bjornburton/ChampBot2016/Firmware/jawAndFireControl/jafco.tex

\input cwebmac

% jafco
\input miniltx
\input graphicx

\nocon % omit table of contents
\datethis % print date on listing

\N{1}{1}Introduction. This is the firmware portion of Jaw and Fire control.

This will facilitate two actions: opening the jaw to release the floating
object and light the target on fire.

The jaw will close by return-spring so the action will to open it.

Fire is a  sequence of opening the jaw, releasing the butane and firing the
ignitor.

\vskip 4 pc
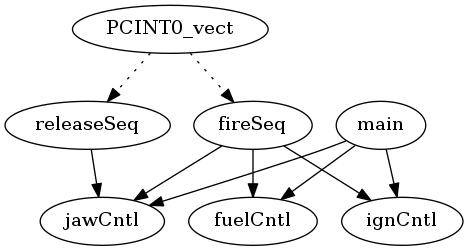
[picture p1: Firmware/jawAndFireControl/jafco.png]


Extensive use was made of the datasheet, Atmel ``Atmel ATtiny25, ATtiny45,
ATtiny85 Datasheet'' Rev. 2586Q–AVR–08/2013 (Tue 06 Aug 2013 03:19:12 PM
EDT)
and ``AVR130: Setup and Use the AVR Timers'' Rev. 2505A–AVR–02/02.
\Y\B\X4:Include\X\6
\X5:Prototypes\X\6
\X6:Global variables\X\par
\fi

\M{2}\PB{\.{"F\_CPU"}} is used to convey the Trinket clock rate.
\Y\B\4\D$\.{F\_CPU}$ \5
\T{8000000\$U\$L}\par
\fi

\M{3}Here are some Boolean definitions that are used.
\Y\B\4\D$\.{ON}$ \5
\T{1}\par
\B\4\D$\.{OFF}$ \5
\T{0}\par
\B\4\D$\.{OPEN}$ \5
\T{1}\par
\B\4\D$\.{CLOSE}$ \5
\T{0}\par
\B\4\D$\.{SET}$ \5
\T{1}\par
\B\4\D$\.{CLEAR}$ \5
\T{0}\par
\fi

\M{4}\B\X4:Include\X${}\E{}$\6
\8\#\&{include} \.{<avr/io.h>}\SHC{ need some port access }\6
\8\#\&{include} \.{<util/delay.h>}\SHC{ need to delay }\6
\8\#\&{include} \.{<avr/interrupt.h>}\SHC{ have need of an interrupt }\6
\8\#\&{include} \.{<avr/sleep.h>}\SHC{ have need of sleep }\6
\8\#\&{include} \.{<avr/wdt.h>}\SHC{ have need of watchdog }\6
\8\#\&{include} \.{<stdlib.h>}\6
\8\#\&{include} \.{<stdint.h>}\par
\U1.\fi

\M{5}\B\X5:Prototypes\X${}\E{}$\6
\&{void} \\{jawCntl}(\\{uint8\_t}\\{state});\SHC{ Jaw open and close }\6
\&{void} \\{fuelCntl}(\\{uint8\_t}\\{state});\SHC{ Fuel on and off }\6
\&{void} \\{ignCntl}(\\{uint8\_t}\\{state});\SHC{ on and off }\6
\&{void} \\{releaseSeq}(\&{void});\6
\&{void} \\{fireSeq}(\&{void});\par
\U1.\fi

\M{6}
My lone global variable is a function pointer.
This lets me pass arguments to the actual interrupt handlers, should I need to.
This pointer gets the appropriate function attached by one of the \PB{%
\.{"ISR()"}}
functions.

\Y\B\4\X6:Global variables\X${}\E{}$\6
\&{void} ${}({*}\\{handleIrq})(\,)\K\NULL{}$;\6
\&{int} \\{main}(\&{void})\1\1\6
$\{{}$\6
\X28:Initialize interrupts\X\6
\X27:Initialize pin inputs\X\6
\X24:Initialize pin outputs\X\6
\X26:Initialize Timer\X\par
\U1.\fi

\M{7}
Of course, any interrupt function requires that bit ``Global Interrupt Enable''
is set; usually done through calling sei(). Doing this after the pin setup is
the best time.
\Y\B\\{sei}(\,);\par
\fi

\M{8}
Rather than burning loops, waiting for something to happen,
the ``sleep'' mode is used.
The specific type of sleep is `idle'.
In idle, execution stops but timers continue.
Interrupts are used to wake it.
\Y\B\X34:Configure to wake upon interrupt\X\par
\fi

\M{9}
This is the loop that does the work.
It should spend most of its time in \PB{\\{sleep\_mode}},
comming out at each interrupt event.

\Y\B\&{for} ( ;  ; \,)\6
$\{{}$\par
\fi

\M{10}
We don't want anything cooking while we are asleap.
\Y\B\\{ignCntl}(\.{OFF});\6
\\{fuelCntl}(\.{OFF});\6
\\{jawCntl}(\.{CLOSE});\par
\fi

\M{11}
Now we wait in ``idle'' for any interrupt event.
\Y\B\\{sleep\_mode}(\,);\par
\fi

\M{12}
If execution arrives here, some interrupt has been detected.
\Y\B\&{if} ${}(\\{handleIrq}\I\NULL{}$)\SHC{ not sure why it would be, but to
be safe }\6
${}\{{}$\1\6
\\{handleIrq}(\,);\6
${}\\{handleIrq}\K\NULL{}$;\SHC{ reset so that the action cannot be repeated }\6
\4${}\}{}$\SHC{ end if handleIrq }\2\6
$\}{}$\SHC{ end for }\6
\&{return} \T{0};\SHC{ it's the right thing to do! }\6
$\}{}$\SHC{ end main() }\par
\fi

\N{1}{13}Interrupt Handling.

\Y\B\&{void} \\{releaseSeq}(\,)\1\1\6
$\{{}$\par
\fi

\M{14}
This sequence will proceed only while the button is held.
\Y\B\\{jawCntl}(\.{OPEN});\6
\&{while} ${}(\R(\.{PINB}\AND(\T{1}\LL\.{PB3}))){}$\1\5
\\{\_delay\_ms}(\T{10});\2\6
\\{jawCntl}(\.{CLOSE}); $\}{}$\par
\fi

\M{15}

\Y\B\&{void} \\{fireSeq}(\,)\1\1\6
$\{{}$\6
\\{uint8\_t}\\{firingState};\7
\&{enum} \&{firingStates} ${}\{{}$\1\6
${}\\{ready},\39\\{opened},\39\\{igniting},\39\\{burning},\39\\{cooling}{}$\2\6
${}\};{}$\7
${}\\{firingState}\K\\{ready}{}$;\par
\fi

\M{16}
This sequence will proceed only while the button is held.
It can terminate after any state.
\PB{\.{"\_delay\_ms()"}} is a handy macro good for $2^{16}$ milliseconds of
delay.
\Y\B\&{while} ${}(\R(\.{PINB}\AND(\T{1}\LL\.{PB4})))$ $\{{}$\par
\fi

\M{17}
The jaw opens here for fire.
\Y\B\&{if} ${}(\\{firingState}\E\\{ready}){}$\5
${}\{{}$\1\6
\\{jawCntl}(\.{OPEN});\6
${}\\{firingState}\K\\{opened};{}$\6
\&{continue};\6
\4${}\}{}$\2\par
\fi

\M{18}
CDI is switched on.
\Y\B\&{if} ${}(\\{firingState}\E\\{opened}){}$\5
${}\{{}$\1\6
\\{ignCntl}(\.{ON});\6
${}\\{firingState}\K\\{igniting};{}$\6
\&{continue};\6
\4${}\}{}$\2\par
\fi

\M{19}
Fuel opens.
\Y\B\&{if} ${}(\\{firingState}\E\\{igniting}){}$\5
${}\{{}$\1\6
\\{fuelCntl}(\.{ON});\6
${}\\{firingState}\K\\{burning};{}$\6
\&{continue};\6
\4${}\}{}$\2\6
\\{\_delay\_ms}(\T{10}); $\}{}$\par
\fi

\M{20}
Once the loop fails we set fuel and ignitor off and close the jaw.
\Y\B\\{ignCntl}(\.{OFF});\6
\\{fuelCntl}(\.{OFF});\6
\\{jawCntl}(\.{CLOSE}); $\}{}$\par
\fi

\N{1}{21}The ISRs.

The ISRs are pretty skimpy as they mostly used to point \PB{\\{handleIrq}(\,)}
to
the correct function.
The need for global variables is minimized.

\fi

\M{22}
This vector responds to the jaw input at pin PB3 or fire input at PB4.
A simple debounce is included.
\Y\B\.{ISR}(\\{PCINT0\_vect})\6
${}\{{}$\1\6
\&{const} \\{int8\_t}\\{high}${}\K\T{32};{}$\6
\&{const} \\{int8\_t}\\{low}${}\K{-}\\{high};{}$\7
${}\\{int8\_t}\\{dbp3}\K\T{0};{}$\6
${}\\{int8\_t}\\{dbp4}\K\T{0};{}$\6
\&{while} ${}(\\{abs}(\\{dbp3})<\\{high}){}$\5
${}\{{}$\1\6
\&{if} ${}(\R(\.{PINB}\AND(\T{1}\LL\.{PB3}))\W\\{dbp3}>\\{low}){}$\1\5
${}\\{dbp3}\MM;{}$\2\6
\&{else} \&{if} ${}((\.{PINB}\AND(\T{1}\LL\.{PB3}))\W\\{dbp3}<\\{high}){}$\1\5
${}\\{dbp3}\PP;{}$\2\6
\\{\_delay\_ms}(\T{1});\6
\4${}\}{}$\2\6
\&{while} ${}(\\{abs}(\\{dbp4})<\\{high}){}$\5
${}\{{}$\1\6
\&{if} ${}(\R(\.{PINB}\AND(\T{1}\LL\.{PB4}))\W\\{dbp4}>\\{low}){}$\1\5
${}\\{dbp4}\MM;{}$\2\6
\&{else} \&{if} ${}((\.{PINB}\AND(\T{1}\LL\.{PB4}))\W\\{dbp4}<\\{high}){}$\1\5
${}\\{dbp4}\PP;{}$\2\6
\\{\_delay\_ms}(\T{1});\6
\4${}\}{}$\2\6
\&{if} ${}(\\{dbp3}\E\\{low}){}$\1\5
${}\\{handleIrq}\K{\AND}\\{releaseSeq};{}$\2\6
\&{else} \&{if} ${}(\\{dbp4}\E\\{low}){}$\1\5
${}\\{handleIrq}\K{\AND}\\{fireSeq};{}$\2\6
\4${}\}{}$\2\par
\fi

\N{1}{23}These are the supporting routines, procedures and configuration
blocks.

Here is the block that sets-up the digital I/O pins.
\fi

\M{24}\B\X24:Initialize pin outputs\X${}\E{}$\6
${}\{{}$\SHC{ 14.4.9 DDRD – The Port D Data Direction Register }\C{ set the
jaw port direction }\1\6
${}\.{DDRB}\MRL{{\OR}{\K}}(\T{1}\LL\.{DDB0}){}$;\C{ set the fuel port direction
}\6
${}\.{DDRB}\MRL{{\OR}{\K}}(\T{1}\LL\.{DDB1}){}$;\C{ set the ignition port
direction }\6
${}\.{DDRB}\MRL{{\OR}{\K}}(\T{1}\LL\.{DDB2});{}$\6
\4${}\}{}$\2\par
\U6.\fi

\M{25}
Timer Counter 0 is configured for ``Phase Correct'' PWM which, according to the
datasheet, is preferred for motor control.
OC0A and OC0B are set to clear on a match which creates a
non-inverting PWM.
\Y\B\par
\fi

\M{26}\B\X26:Initialize Timer\X${}\E{}$\6
${}\{{}$\SHC{ 15.9.1 TCCR0A – Timer/Counter Control Register A }\1\6
${}\.{TCCR0A}\MRL{{\OR}{\K}}(\T{1}\LL\.{WGM00}){}$;\SHC{ Phase correct, mode 1
of PWM (table 15-9) }\6
${}\.{TCCR0A}\MRL{{\OR}{\K}}(\T{1}\LL\.{COM0A1}){}$;\SHC{ Set/Clear on
Comparator A match (table 15-4) }\6
${}\.{TCCR0A}\MRL{\AND{\K}}\CM(\T{1}\LL\.{COM0A0}){}$;\SHC{ Set  on Comparator
A match (table 15-4) }\6
${}\.{TCCR0A}\MRL{{\OR}{\K}}(\T{1}\LL\.{COM0B1}){}$;\SHC{ Set/Clear on
Comparator B match (table 15-7) }\6
${}\.{TCCR0A}\MRL{\AND{\K}}\CM(\T{1}\LL\.{COM0B0}){}$;\SHC{ Set on Comparator B
match (table 15-7) }\SHC{ 15.9.2 TCCR0B – Timer/Counter Control Register B }\6
${}\.{TCCR0B}\MRL{{\OR}{\K}}(\T{1}\LL\.{CS01}){}$;\SHC{ Prescaler set to clk/8
(table 15-9) }\6
\4${}\}{}$\2\par
\U6.\fi

\M{27}\B\X27:Initialize pin inputs\X${}\E{}$\6
${}\{{}$\C{ set the jaw input pull-up }\1\6
${}\.{PORTB}\MRL{{\OR}{\K}}(\T{1}\LL\.{PORTB3}){}$;\C{ set the fire input
pull-up }\6
${}\.{PORTB}\MRL{{\OR}{\K}}(\T{1}\LL\.{PORTB4});{}$\6
\4${}\}{}$\2\par
\U6.\fi

\M{28}\B\X28:Initialize interrupts\X${}\E{}$\6
${}\{{}$\C{ enable  change interrupt for jaw input }\1\6
${}\.{PCMSK}\MRL{{\OR}{\K}}(\T{1}\LL\.{PCINT3}){}$;\C{ enable  change interrupt
for fire input }\6
${}\.{PCMSK}\MRL{{\OR}{\K}}(\T{1}\LL\.{PCINT4}){}$;\C{ General interrupt Mask
register }\6
${}\.{GIMSK}\MRL{{\OR}{\K}}(\T{1}\LL\.{PCIE});{}$\6
\4${}\}{}$\2\par
\U6.\fi

\M{29}
Here is a simple procedure to operate the jaw.
\Y\B\&{void} \\{jawCntl}(\\{uint8\_t}\\{state})\6
${}\{{}$\1\6
\&{if} (\\{state})\5
${}\{{}$\1\6
${}\.{OCR0A}\K\T{\^ff\$U};{}$\6
\\{\_delay\_ms}(\T{250});\6
${}\.{OCR0A}\K\T{\^cc\$U};{}$\6
\4${}\}{}$\2\6
\&{else}\5
${}\{{}$\1\6
${}\.{OCR0A}\K\T{\^00\$U};{}$\6
\4${}\}{}$\2\6
\4${}\}{}$\2\par
\fi

\M{30}
Here is a simple procedure to operate the fuel.
\Y\B\&{void} \\{fuelCntl}(\\{uint8\_t}\\{state})\6
${}\{{}$\1\6
\&{if} (\\{state})\5
${}\{{}$\1\6
${}\.{OCR0B}\K\T{\^ff\$U};{}$\6
\\{\_delay\_ms}(\T{250});\6
${}\.{OCR0B}\K\T{\^ff\$U};{}$\6
\4${}\}{}$\2\6
\&{else}\5
${}\{{}$\1\6
${}\.{OCR0B}\K\T{\^00\$U};{}$\6
\4${}\}{}$\2\6
\4${}\}{}$\2\par
\fi

\M{31}
Here is a simple procedure to operate the ignition.
\Y\B\&{void} \\{ignCntl}(\\{uint8\_t}\\{state})\6
${}\{{}$\1\6
${}\.{PORTB}\K\\{state}\?\.{PORTB}\OR(\T{1}\LL\.{PORTB2}):\.{PORTB}\AND\CM(%
\T{1}\LL\.{PORTB2});{}$\6
\4${}\}{}$\2\par
\fi

\M{32}
See section the datasheet for details on the Watchdog Timer.
We are not using it right now.
\fi

\M{33}\B\X33:Initialize watchdog timer\X${}\E{}$\6
${}\{{}$\1\6
${}\.{WDTCR}\MRL{{\OR}{\K}}(\T{1}\LL\.{WDCE})\OR(\T{1}\LL\.{WDE});{}$\6
${}\.{WDTCR}\K(\T{1}\LL\.{WDIE})\OR(\T{1}\LL\.{WDP2}){}$;\SHC{ reset after
about 0.25 seconds }\6
\4${}\}{}$\2\par
\fi

\M{34}
Setting these bits configure sleep\_mode() to go to ``idle''.
Idle allows the counters and comparator to continue during sleep.

\Y\B\4\X34:Configure to wake upon interrupt\X${}\E{}$\6
${}\{{}$\1\6
${}\.{MCUCR}\MRL{\AND{\K}}\CM(\T{1}\LL\.{SM1});{}$\6
${}\.{MCUCR}\MRL{\AND{\K}}\CM(\T{1}\LL\.{SM0});{}$\6
\4${}\}{}$\2\par

\U8.\fi

\inx
\fin
\con
