bjornburton/ChampBot2016/Firmware/propulsion/piruett.pdf

§1 | PIRUETT | INTRODUCTION | 1

September 22, 2016 at 15:41

1. | Introduction. | This is the firmware portion of the propulsion and dive system for our 2016 Champbot.
It features separate thrust and steering, including piruett turning.
It facilitates lateral motion by taking “thrust” and “radius” pulse-width, or PWC, inputs from the RC receiver and converting them to the appropriate motor actions.
Thrust is receiver-channel 2, entering analog input ADC1 (PC1), and Radius is channel 1, at ADC0 (PC0). The action will be similar to driving an RC car or boat. By keeping it natural, it should be easier to navigate the course than with a skid-steer style control.
For PWM we are using Timer Counter 0. We are using the Wingxing DBH−01 (B/C) and the Inputs are unique on this. The PWM logic input goes to two different pins, depending on direction! The non-PWM pin must be held low. This is a big problem since PWM outputs have dedicated pins. Two AVR timers would be needed to control two motors; wasteful.
The odd example in the DBH−01 datasheet has PWM on IN1 and LOW on IN2 for forward. For reverse, LOW on IN1 and PWM on IN2.
Ruling out multiple timers (four comparators), additional outputs, or a PLD, the best solution we could find was a adding glue logic. A single 74F02 was chosen; a quad NOR. Keeping this solution simple, i.e. one

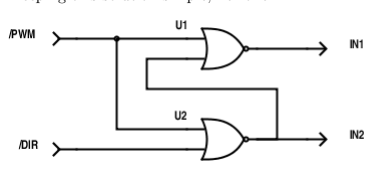
[picture p2: figure]

gate-type and on one chip, required that the AVR outputs be inverted. | a
This one chip handles the logic for both motors. With this, the AVR outputs direction on one pin and PWM
on the other. At the H-Bridge, the pin receiving PWM is selected based on motor direction. The remaining,
non-PWM pin, is held low.
PWM is OC0B and OC0A (PD5 and PD6), located on Trinket pins 5 an 6. The A fail-safe relay output will be at pin 8 (PB0).
For 2016 an autonomous dive function has been added. As in 2015, dive is performed by full reverse thrust but, with this new feature, this thrust is modulated to maintain a specified depth, as determined by a pressure sensor in the electronics bay. The sensor signal connects to ADC2 (PC2) through a voltage divider. The divider scales the 5 volt range of the sensor to the 1.1 volt range of the ADC. By program, it will maintain this depth for 12 seconds, two seconds longer than required.
This timing is through a tick interrupt by Timer Counter 2.
Dive is initiated by a low signal on FTDI pin #4. A relay circuit across FTDI #4 and #1 (Gnd) will do this.

2 | IMPLEMENTATION | PIRUETT | §2
2. | Implementation. | The Flysky FS-IA6 receiver has six PWC channels. The pulse-width from the
receiver is at 20 ms intervals but is adjustable. The pulses start simultaneously but end at the time corresponding to the controls. The on-time probably ranges from 1000–2000 µs including trim. 1500 µs is the pulse-width for center or stop. The levers may cover ±400 µs and the trim may cover the last 100 µs. The median time will be subtracted from them for a pair of signed values thrust and radius. The value will be scaled.
The thrust and radius will be translated to power to the port and starboard motors. When near median the motors will be disabled through a dead-band. Stiction in the motor probably wouldn’t allow it to move anyway, at this low duty-cycle. Both the PWM and safety relay will open. The motors will also be disabled when there are no input pulses; in this way champ wont run-off if the range is exceeded. This function is handled by the watchdog timer.
The radius control will also be the rotate control, if thrust is zero. Timer-Counter 0 is used for the PWM. The ATmega328 has a 16 bit PWMs with two comparators, Timer 1. This has an “Input Capture Unit” that may be used for PWC decoding. PWC being the type of signal from the RC receiver. That seems like as elegant a solution as I will find and it is recommended by Atmel to use it for this purpose.
The best way to use this nice feature is to take the PWC signals into the MUX, through the comparator and into the Input Capture Unit.
For the PWC measurement, this app note, AVR135, is helpful: www.atmel.com/images/doc8014.pdf In the datasheet, section 16.6.3 is helpful.
After each pulses captured from its respective channel, there’s an 18 ms dead-time. That’s over 250,000 clock cycles. This will provide ample time to sample pressure and do all of the math and set the motor PWMs.
Extensive use was made of the datasheet, Atmel “Atmel-8271I-AVR- ATmega-Datasheet 10/2014”.

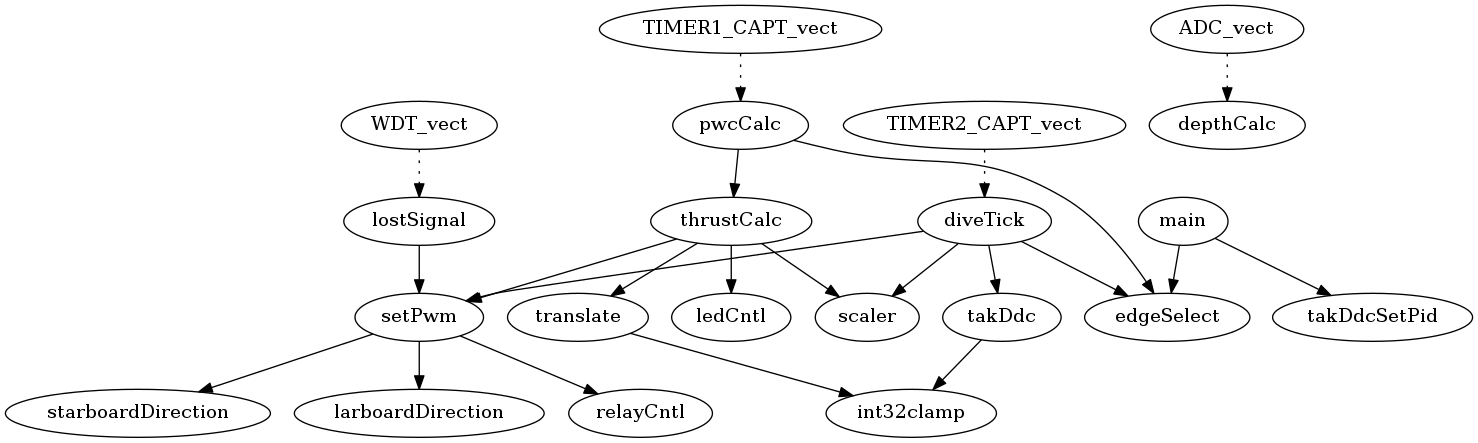
[picture p3: figure]

This is essentially a boat and so I originally wanted to use the word “Port” for the left-hand side, when facing the front. On a micro-controller that name is used for all of the ports so I chose the older word “larboard”.
hInclude 7 i
h Types 8 i
hPrototypes 14 i
h Global variables 15 i
3. F_CPU is used to convey the Trinket Pro clock rate. #define F_CPU 16000000UL

§4 | PIRUETT | BOOLEAN DEFINITIONS USED EVERYWHERE | 3
4. Boolean definitions used everywhere.
#define ON 1

#define OFF 0

#define SET 1

#define CLEAR 0

#define TRUE 1

#define FALSE 0

#define FORWARD 1

#define REVERSE 0

#define CLOSED 1

#define OPEN 0

#define AUTOMATIC 1

#define MANUAL 0

#define STOPPED 0

4 | OTHER DEFINITIONS | PIRUETT | §5
5. | Other definitions. | It is critical that MAX_DUTYCYCLE is 98% or less.
#define MAX_DUTYCYCLE 98 | /∗ 98% to support charge pump of bridge-driver ∗/

§6 | PIRUETT | INTERRUPT DISABLERS TO ALLOW DEBUGGING | 5
6. Interrupt disablers to allow debugging.
#define WATCHDOG ON /∗ reset ∗/

#define ANALOG ON

#define TICK ON | /∗ TIMER2 ∗/

#define CAPTURE ON | /∗ TIMER1 ∗/

### 7. hInclude 7 i ≡

#include <avr/io.h> | /∗ need some port access ∗/

#include <avr/interrupt.h> | /∗ have need of an interrupt ∗/

#include <avr/sleep.h> | /∗ have need of sleep ∗/

#include <avr/wdt.h> | /∗ have need of watchdog ∗/

#include <stdlib.h>

#include <stdint.h>

#include <assert.h>

This code is used in section 2.

8. This structure is for the DDC or Direct Digital Control. k p is the proportional coefficient. The larger it is, the bigger will be the effect of control. k i is the integral coefficient in resets per unit-time. k d is the derivative coefficient. m is the output. Whatever is minimal power is probably a good output to start with. min is the minimum allowed output. max is the maximum allowed output. mode can be manual or automatic;
#define PIDSAMPCT 4 /∗ The PID sample count for derivatives ∗/

h Types 8 i ≡
typedef struct {
| int16 t k p; | /∗ proportional action parameter ∗/
| int16 t k i ; | /∗ integral action parameter in R/T ∗/
| int16 t k d ; | /∗ derivative action parameter ∗/
int16 tt; | /∗ sampling period ∗/
int16 t setpoint; | /∗ setpoint ∗/
| int16 t pPvN [PIDSAMPCT]; | /∗ process value history ∗/
| int16 t ∗ pPvLast; | /∗ process value latest location ∗/
int16 tm; | /∗ latest output ∗/
int16 t mMin; | /∗ min output ∗/
int16 t mMax ; | /∗ max output ∗/
| int8 t mode ; | /∗ 1 == automatic, 0 == manual ∗/
} ddcParameters;

See also sections 9, 10, 11, and 12.

This code is used in section 2.

6 | PINPUT S→EDGE MAY BE ANY OF THESE | PIRUETT | §9
9. pInput s→edge may be any of these.
h Types 8 i +≡
typedef enum {
CH1RISE, | /∗ The rising edge of RC’s remote channel 1 ∗/
CH1FALL, | /∗ The falling edge of RC’s remote channel 1 ∗/
CH2RISE, | /∗ The rising edge of RC’s remote channel 2 ∗/
CH2FALL, | /∗ The falling edge of RC’s remote channel 2 ∗/
ALLOWPRESSURE | /∗ Period to allow pressure check ∗/
} edges t;

§10 | PIRUETT | PINPUT S→CONTROLMODE MAY BE ANY OF THESE | 7
10. pInput s→controlMode may be any of these.
h Types 8 i +≡
typedef enum {
IDLE, | /∗ The mode of being surfaced ∗/
| REMOTE, | /∗ The mode of being surfaced ∗/
| DIVING, | /∗ The mode of actively diving ∗/
| SUBMERGED | /∗ The mode of being submerged ∗/
} controlModes t;
11. Here is the structure type to keep track of the state of inputs, e.g. servo timing. Rise and Fall indicate the PWC edge times. edge is set to the edge type expected for the interrupt.
h Types 8 i +≡
typedef struct {
uint16 t ch1rise ;
uint16 t ch1fall ;
uint16 t ch2rise ;
uint16 t ch2fall ;
uint16 t ch1duration;
uint16 t ch2duration;
| int8 t stopped ; | /∗ boolean TRUE or FALSE ∗/
edges t edge ;
controlModes t controlMode ;
| int16 t setDepth ; | /∗ depth setpoint in cm; ∗/
| int16 t tolDepth ; | /∗ depth tolerance in cm ∗/
| int16 t processDepth ; | /∗ signed depth in cm ∗/
| const uint16 t pwcMinIn; | /∗ input, minimum ∗/
| const uint16 t pwcMaxIn; | /∗ input, maximum ∗/
ddcParameters ∗pPid s ;
} inputStruct;
12. Here is a structure type to keep track of the state of translation items. h Types 8 i +≡
typedef struct {
int16 t thrust; | /∗ -255 to 255 ∗/
int16 t radius ; | /∗ -255 to 255 ∗/
const int16 t track ;
int16 t starboardOut; | /∗ -255 to 255 ∗/
int16 t larboardOut; | /∗ -255 to 255 ∗/
| const int8 t deadBand ; | /∗ width of zero in terms of output units ∗/
} transStruct;
13. This structure type keeps track of the state of dive and submerge.

8 | PINPUT S→CONTROLMODE MAY BE ANY OF THESE | PIRUETT | §14

### 14. hPrototypes 14 i ≡

void relayCntl(int8 t state );
void ledCntl(int8 t state );
void larboardDirection(int8 t state ); void starboardDirection(int8 t state ); void depthCalc(inputStruct ∗); void diveTick (inputStruct ∗); void pwcCalc(inputStruct ∗); void edgeSelect(inputStruct ∗); void translate (transStruct ∗); void setPwm(int16 t, int16 t);
void lostSignal(inputStruct ∗);
void thrustCalc(inputStruct ∗);
int32 t scaler (int32 t input, int32 t pwcMinIn, int32 t pwcMaxIn, int32 t minOut, int32 t maxOut); int32 t int32clamp(int32 t value , int32 t min, int32 t max );
void takDdcSetPid (ddcParameters ∗, int16 t p, int16 ti, int16 t d, int16 tt);
int16 t takDdc(ddcParameters ∗);

This code is used in section 2.

15. My lone global variable is a function pointer. This lets me pass arguments to the actual interrupt handlers and acts a bit like a stack to store the next action. This pointer gets the appropriate function attached by the ISR( ) function.
This input structure is to contain all of the external inputs.
h Global variables 15 i ≡
void (∗handleIrq )(inputStruct ∗) = Λ;

This code is used in section 2.

§16 | PIRUETT | THE BEGINNING | 9
16. The Beginning.
int main(void)
{
17. Initially we will have the motors off and wait for the first rising edge from the remote. The PID parameters are instantiated and loaded with safe defaults. takDdcSetPid ( ) is used to set the parameters. The output, m, is ± is the range of uint8 and so positive. Note also that the maximum duty cycle is used as maximum. The setpoint of 100 cm is set here.
inputStruct ∗pInput s = &(inputStruct) {
.edge = CH1RISE,
.controlMode = IDLE,
.setDepth = 100L,
.pPid s = &(ddcParameters) { .mMin = −10000L,
.mMax = 10000L,
.mode = AUTOMATIC
}
};
pInput s~

pPid s~

setpoint = pInput s~

setDepth ;
takDdcSetPid (pInput s~
pPid s , 20, 2, 2, 1);
18. Here the interrupts are disabled so that configuring them doesn’t set it off.
cli( );
hInitialize watchdog timer 74 ihInitialize capture mode 70 ihInitialize pin inputs 67 ihInitialize pin outputs 66 ihInitialize tick timer 72 i
19. Any interrupt function requires that bit “Global Interrupt Enable” is set.
sei( );

20.
The PWM is used to control larboard and starboard motors through OC0A (D5) and OC0B (D6), respec-tively.
hInitialize the Timer Counter 0 for PWM 76 i
21. Rather than burning loops, waiting the balance of 18 ms for something to happen, the sleep mode is used. The specific type of sleep is idle . In idle, execution stops but timers, like the Input Capture Unit and PWM continue to operate. Another thing that will happen during sleep is an ADC conversion from the pressure sensor. Interrupts “Input Capture”, “tick”, “ADC” and “Watchdog”, are used to wake it up. It’s important to note that an ISR procedure must be defined to allow the program to step past the sleep statement, even if it is empty. This stumped me for a good while.
h Configure to idle on sleep 68 i
22. Since edge is already set, calling edgeSelect( ) will get it ready for the first rising edge of channel 2. Subsequent calls to edgeSelect rotates it to the next edge type.
edgeSelect(pInput s );

10 | THE “BIG” LOOP | PIRUETT | §23
23. | The “Big” Loop. | This is the loop that does the work. It should spend most of its time in
“sleep mode”, coming out at each interrupt event caused by an edge, tick or watchdog timeout.
for ( ; ; ) {
24. Now that a loop is started, the drive PWM has its values and we wait in idle for the edge on the channel selected. Each successive loop will finish in the same way. After three passes translation s will have good values to work with.
First, if we are still in this loop, ensure that the watchdog stays in interrupt mode.
if WATCHDOG WDTCSR |= (1 WDIE);
else WDTCSR &= ∼(1 WDIE);
endif sleep mode ( );
25. If execution arrives here, some interrupt has woken it from sleep and some vector has possibly run. That possibility is first checked. The pointer handleIrq will be assigned the value of the responsible function and then executed. After that the IRQ is nulled so as to avoid repeating the action, should it wakeup for some other reason.
if (handleIrq 6= Λ) {
handleIrq (pInput s );
handleIrq = Λ;
}
} /∗ end for ∗/
return 0;
} /∗ end main() ∗/

§26 | PIRUETT | INTERRUPT SERVICE ROUTINES | 11
26. Interrupt Service Routines.
27. Here is the ISR that fires at each captured edge. Essentially it grabs and processes the “Input Capture” data.
ISR(TIMER1 CAPT vect)
{
handleIrq = &pwcCalc;
}
28. Here is the ISR that fires at at about 64 Hz for the main dive tick. This is used for the dive-control loop.
ISR(TIMER2 COMPA vect)
{
handleIrq = &diveTick ;
}
29. Here is the ISR that fires after a successful ADC conversion. The ADC is used to determine depth from pressure.
ISR(ADC vect)
{
handleIrq = &depthCalc;
}
30. When the watchdog timer expires, this vector is called. This is what happens if the remote’s transmitter signal is not received. It calls a variant of pwcCalc that only sets the controlMode to IDLE.
ISR(WDT vect)
{
handleIrq = &lostSignal ;
}

12 | INPUT CAPTURE | PIRUETT | §31
31. | Input Capture. | This procedure computes the durations from the PWC signal edge capture values
from the Input Capture Unit. With the levers centered the durations should be about 1500 µs so at 16 Mhz the count should be near 24000. The range should be 17600 to 30400 for 12800 counts, well within the range of the 2¹⁶ counts of the 16 bit register.

void pwcCalc(inputStruct ∗pInput s )
{
32. This is called by the input capture interrupt vector. If we are diving of submerged there is an early return so that the dive cannot be interrupted.
Counting always starts on the rising edge and stops on the falling. On the falling edges we can compute the durations using modulus subtraction.
Arrival at the last case establishes that there was a signal and sets mode to REMOTE.
if (pInput s~

controlMode ≥ DIVING) return; switch (pInput s~

edge ) {
case CH1RISE: pInput s~

ch1rise = ICR1;
pInput s~

edge = CH1FALL;
wdt reset( );
break;
case CH1FALL: pInput s~

ch1fall = ICR1;
pInput s~

ch1duration = pInput s~

ch1fall − pInput s~
ch1rise ;
pInput s~
edge = CH2RISE;
wdt reset( );
break;
case CH2RISE: pInput s~
ch2rise = ICR1;
pInput s~

edge = CH2FALL;
wdt reset( );
break;
case CH2FALL: pInput s~

ch2fall = ICR1;
pInput s~
ch2duration = pInput s~

ch2fall − pInput s~
ch2rise ;
pInput s~

edge = ALLOWPRESSURE;
if (pInput s~
controlMode ≡ IDLE) pInput s~ controlMode = REMOTE;
wdt reset( );
break;
case ALLOWPRESSURE: pInput s~ edge = CH1RISE;
}
edgeSelect(pInput s );
thrustCalc(pInput s );
}

§33 | PIRUETT | THRUST CALCULATOR | 13
33. | Thrust Calculator. | This procedure connects pwc to pwm.
void thrustCalc(inputStruct ∗pInput s )
{
34. The Flysky FS-IA6 receiver channels start with a synchronous rising edge so we will start looking for that by setting edge to look for a rise on channel 1.
Center position of the controller should result in a count of about 23392, hard About 4
| | 5

of the range are
the full swing of the stick, without trim. This is from about 25990 and 41850 ticks. This is when the FlySky is set at 50 Hz. It seems that the width is scaled by frequency.
. pwcMinIn . pwcMaxIn are the endpoints of the normal stick travel. The units are raw counts as the Input Capture Register will use.
At some point a calibration feature could be added which could populate these but the numbers here were from trial and error and seem good.
Until we have collected the edges we will assume there is no signal.
const uint16 t pwcMinIn = 25990UL; | /∗ minimum normal value from receiver ∗/
const uint16 t pwcMaxIn = 41850UL; | /∗ maximum normal value from receiver ∗/
const int16 t minOut = −255L; | /∗ minimum value of thrust ∗/
const int16 t maxOut = 255L; | /∗ maximum value of thrust ∗/
35. This is the structure that holds output parameters. Track represents the prop-to-prop distance. The units really don’t mean anything physical. It should probably be adjusted to minimize turn radius. With the Flysky this value is about 240.
transStruct ∗pTranslation s = &(transStruct) {.deadBand = 10, .track = 240};
36. Here we scale the PWC durations and apply the “deadBand”.
{
int16 t outputCh1 ;
int16 t outputCh2 ;
if (pInput s~

controlMode 6= IDLE) {
outputCh1 = scaler (pInput s~

ch1duration, pwcMinIn, pwcMaxIn, minOut, maxOut); outputCh2 = scaler (pInput s~ ch2duration, pwcMinIn, pwcMaxIn, minOut, maxOut); }
else {
outputCh1 = 0;
outputCh2 = 0;
} /∗ Apply deadband ∗/
outputCh1 = (abs (outputCh1 ) > pTranslation s~ deadBand ) ? outputCh1 : 0; outputCh2 = (abs (outputCh2 ) > pTranslation s~ deadBand ) ? outputCh2 : 0; pTranslation s~

radius = outputCh1 ;
pTranslation s~

thrust = outputCh2 ;
}
translate (pTranslation s ); if (pInput s~

controlMode ≡ REMOTE) setPwm(pTranslation s~ larboardOut, pTranslation s~

starboardOut);

14 | THRUST CALCULATOR | PIRUETT | §37
37. Here we check if dive is allowed and, if so, the dive signal is checked. If that signal is LOW, move to DIVING mode. The LED is used to indicate when both channels PWM’s are zeros.
if (pTranslation s~

larboardOut ∨ pTranslation s~

starboardOut) {
pInput s~

stopped = FALSE;
ledCntl(OFF);
}
else {
pInput s~

stopped = TRUE;
ledCntl(ON);
}
}

§38 | PIRUETT | LOST SIGNAL HANDLER | 15
38. | Lost Signal Handler. | This procedure sets output to zero and resets edge in the event of a lost
signal.
void lostSignal(inputStruct ∗pInput s )
{
if (pInput s~

controlMode ≤ REMOTE) pInput s~ controlMode = IDLE;
if (pInput s~

controlMode ≡ IDLE) setPwm(0, 0); pInput s~

edge = ALLOWPRESSURE;
wdt reset( );
}

16 | DIVE TIMER AND SEQUENCER | PIRUETT | §39
39. | Dive Timer and Sequencer. | This procedure maintains various timers involved in diving. It
manages input debounce and the dive to no-dive toggle. It prevents diving while under way. It limits diving and submersion times.
void diveTick (inputStruct ∗pInput s )
{
const uint8 t oneSecond = 64;
const uint8 t debounceTime = oneSecond /8; static uint8 t tickCount = 0;
const uint16 t divingSeconds = 20 ∗ oneSecond ; static uint16 t divingCount = divingSeconds ;
const uint16 t submersedSeconds = 15 ∗ oneSecond ;
static uint16 t submersedCount = submersedSeconds ;
40. We are here 64 times per second through the tick interrupt. First, if a pressure reading is allowed, use edgeSelect to set up for a reading. It will only get the ADC value when ALLOWPRESSURE is true, happening after both pwc channels have been read.
Once diving, or better, ALLOWPRESSURE is ensured. This way as the signal is lost, it can’t inadvertantly start looking to the PWC signal. If that happened it would drive to the lake-bottom!
if (pInput s~
edge ≡ ALLOWPRESSURE) edgeSelect(pInput s );

### 41. This will count off ticks for a 1

| 4

second event. This is the Direct Digital Control crunch interval. Every interval the depth is collected and DDC is run so that it is always ready to take the reins. Once it is diving or submerged it will reset the watch dog timer.
if (¬(tickCount += oneSecond /4)) {
∗pInput s~
pPid s~

pPvLast = pInput s~

processDepth ;
takDdc(pInput s~

pPid s );
if (pInput s~
controlMode ≥ DIVING) {
int16 t output = scaler (−(pInput s~

pPid s~m), pInput s~
pPid s~mMin, pInput s~

pPid s~mMax ,
−(MAX_DUTYCYCLE ∗ UINT8_MAX)/100L, 0L);
setPwm(output, output);
pInput s~
edge = ALLOWPRESSURE; | /∗ Ensure we don’t loose this! ∗/
wdt reset( ); | /∗ Here we see if we are deep enough to transition to submerged ∗/
if (∗pInput s~
pPid s~

pPvLast ≥ (pInput s~

setDepth − pInput s~

tolDepth ))
pInput s~

controlMode = SUBMERGED;
}
else /∗ To ensure output is safe when it enters DIVING mode ∗/ pInput s~
pPid s~m = 0L;
}

§42 | PIRUETT | DIVE TIMER AND SEQUENCER | 17
42. This is the debounce section. First we ensure that the relay stays open long enough before accepting an input. Next we ensure the relay stays closed long enough.
static int8 t debounceSet = FALSE;
if (debounceSet) {
static uint8 t debcount = debounceTime ;
if ((PIND & (1 PD0)) ∧ debcount < debounceTime ) debcount ++; else if ((∼PIND & (1 PD0)) ∧ debcount > 0) debcount −−;
if (¬debcount) {
if (pInput s~

stopped ≡ TRUE ∧ pInput s~

controlMode < DIVING) {
pInput s~

controlMode = DIVING;
debounceSet = FALSE;
}
else if (pInput s~

controlMode ≥ DIVING) {
pInput s~

controlMode = IDLE;
debounceSet = FALSE;
}
debcount = debounceTime ;
}
}
else {
static uint8 t debcount = debounceTime ;
if ((∼PIND & (1 PD0)) ∧ debcount < debounceTime ) debcount ++; else /∗ The reset state ∗/
if ((PIND & (1 PD0)) ∧ debcount > 0) debcount −−;
if (¬debcount) {
debounceSet = TRUE;
debcount = debounceTime ;
}
}
43. These two timers limit the duration of these modes. if (pInput s~
controlMode ≡ IDLE) divingCount = submersedCount = 0; divingCount = (pInput s~

controlMode ≡ DIVING) ? divingCount − 1 : divingSeconds ; if (divingCount ≡ 0) pInput s~ controlMode = IDLE;
submersedCount = (pInput s~

controlMode ≡ SUBMERGED) ? submersedCount − 1 : submersedSeconds ; if (submersedCount ≡ 0) pInput s~ controlMode = IDLE;
}

18 | PRESSURE SENSOR CONDITIONER | PIRUETT | §44
44. | Pressure Sensor Conditioner. | This procedure will filter ADC results for a pressure in terms of
ADC units and convert that to signed integer depth in centimeters. First the comparator is reconnected to the MUX so that we miss as few RC events as possible. There is a moving average filter of size 16 or about 1
| | | 4
second in size. It can be made larger, if needed. That size is efficient since the division is a binary right shift of 4 places. Since the ADC is a mere 10 bits, and 2¹⁰ × 32 is only 2¹⁵, the sum may safely be of size uint16 t even at that.
Next, this must be in terms of depth. The sensor was tested and has a 0.49 V output at the surface and that output increases by 12 mV per centimeter of depth.
By measurement of the sensor’s output, 1000 units of ADC is 4.14 Volts or 0.00414 mV/unit. Offset is then 0.49
0.00414 for 118 units. That means 118 ADC units at the surface.
| Gain is 0.00414
0.012 | for 0.345. Since 0.345 is a floating point, and we don’t want slow, massive floating-point
libraries, we can multiply this by 2⁵
, and round it, for a gain of 11. Depth will then be in a large integer of
1
32 cm. Then we will divide by 32 to get to integer centimeters.
Conversion to depth is signed since the offset is fixed and the sensor may drift a bit. The danger in an unsigned is that when surfaced, the offset subtraction may result in an instant extreme, apparent depth. void depthCalc(inputStruct ∗pInput s )
{
const int16 t offset = 118L; | /∗ units of ADC offset from zero depth ∗/
const int16 t gain = 11L; | /∗ units of gain in 1/32 cm per ADC unit ∗/
static int16 t buffStart[(1 4) + 1] = {0};
const int16 t ∗buffEnd = buffStart + ((1 4) − 1);
static int16 t ∗buffIndex = buffStart;
static int16 t sum = 0; /∗ Accommodates size up to 1¡¡6 only ∗/
45. Now that we have our sample, pass control back to the input capture interrupt.
ADCSRA &= ∼(1 ADEN); | /∗ Reconnect the MUX to the comparator ∗/
ADMUX = (ADMUX & #f0) | 1U; | /∗ Set to mux channel 1 ∗/
sum −= ∗buffIndex ; | /∗ Remove the oldest item from the sum ∗/
∗buffIndex = (uint16 t)ADCW; | /∗ Read the whole 16 bit word with ADCW ∗/
sum += ∗buffIndex ; | /∗ Include this new item in the sum ∗/
buffIndex = (buffIndex 6= buffEnd ) ? buffIndex + 1 : buffStart;
pInput s~

processDepth = (((sum 4) − offset) ∗ gain)/32L; }

§46 | PIRUETT | IMPUT CAPTURE EDGE SELECTOR | 19
46. | Imput Capture Edge Selector. | The procedure edgeSelect configures the “Input Capture” unit
to capture on the expected edge type from the remote control’s proportional signal.
void edgeSelect(inputStruct ∗pInput s )
{
switch (pInput s~

edge ) {
case ALLOWPRESSURE: ADCSRA |= (1 ADEN);
/∗ Connect the MUX to the ADC and enable it ∗/
| ADMUX = (ADMUX & #f0) | 2U; | /∗ Set MUX to channel 2 ∗/
return; | /∗ no need to stick around ∗/
| case CH1RISE: | /∗ To wait for rising edge on rx-channel 1 ∗/
| ADMUX = (ADMUX & #f0) | 0U; | /∗ Set to mux channel 0 ∗/
TCCR1B |= (1 ICES1); | /∗ Rising edge (23.3.2) ∗/
break;
| case CH1FALL: ADMUX = (ADMUX & #f0) | 0U; | /∗ Set to mux channel 0 ∗/
| TCCR1B &= ∼(1 ICES1); | /∗ Falling edge (23.3.2) ∗/
break;
| case CH2RISE: | /∗ To wait for rising edge on rx-channel 2 ∗/
| ADMUX = (ADMUX & #f0) | 1U; | /∗ Set to mux channel 1 ∗/
TCCR1B |= (1 ICES1); | /∗ Rising edge (23.3.2) ∗/
break;
| case CH2FALL: ADMUX = (ADMUX & #f0) | 1U; | /∗ Set to mux channel ∗/
| ADCSRA &= ∼(1 ADEN); | /∗ Reconnect the MUX to the comparator ∗/
| TCCR1B &= ∼(1 ICES1); | /∗ Falling edge (23.3.2) ∗/
}
47. Since the edge has now been changed, the Input Capture Flag should be cleared. It seems odd but clearing it involves writing a one to it.
TIFR1 |= (1 ICF1); /∗ (per 16.6.3) ∗/
}

20 | UNIVERSAL SCALER | PIRUETT | §48
48. | Universal Scaler. | The scaler function takes an input and scales it, This may be in time, from the
Input Capture Register, returning a value scaled by the parameters in structure inputScale s . This is used to translate the stick position of the remote, and output from the DDC, into terms that we can use to set the PWM.
int32 t scaler (int32 t input, int32 t pwcMinIn, int32 t pwcMaxIn, int32 t minOut, int32 t maxOut)
{
49. First, we can solve for the obvious cases. This can easily happen if the trim is shifted and the lever is at its limit.
if (input > pwcMaxIn) return maxOut;
if (input < pwcMinIn) return minOut;
50. If it’s not that simple, then compute the gain and offset and then continue in the usual way. This is not really an efficient method, recomputing gain and offset every time but we are not in a rush and it makes it easier since, if something changes, I don’t have to manually compute and enter these values. OK, maybe I could use the preprocessor but compiler optimization probably makes this pretty good.
The constant ampFact amplifies values for math to take advantage of the high bits for precision.
const int32 t ampFact = 128LL;
int32 t gain = (ampFact ∗ (pwcMaxIn − pwcMinIn))/(maxOut − minOut);
int32 t offset = ((ampFact ∗ pwcMinIn)/gain) − minOut;
return (ampFact ∗ input /gain) − offset;
}

§51 | PIRUETT | RADIUS TRANSLATOR | 21
51. | Radius Translator. | We need a way to translate thrust and radius in order to carve a turn.
This procedure should do this but it’s not going to be perfect as drag and slippage make thrust increase progressively more than speed. Since the true speed is not known, we will use thrust. It should steer OK as long as the speed is constant and small changes in speed should not be too disruptive. The sign of larboardOut and starboardOut indicates direction. As before, the constant ampFact amplifies values for math so to take advantage of the high bits for precision.
This procedure is intended for values from -255 to 255 or INT16_MIN to INT16_MAX.
max is set to support the limit of the bridge-driver’s charge-pump.
void translate (transStruct ∗trans s )
{
int16 t speed = trans s~

thrust; /∗ we are assuming it’s close ∗/ int16 t rotation;
int16 t difference ;
int16 t piruett;
static int8 t lock = OFF;
const int8 t pirLockLevel = 15;
const int16 t max = (MAX_DUTYCYCLE ∗ UINT8_MAX)/100L;
const int16 t ampFact = 128L;
52. Here we convert desired radius to thrust-difference by scaling to speed. Then that difference is converted to rotation by scaling it with track . The radius sensitivity is adjusted by changing the value of track . From testing it seems like this track value is fine.
difference = (speed ∗ ((ampFact ∗ trans s~

radius )/UINT8_MAX))/ampFact; rotation = (trans s~

track ∗ ((ampFact ∗ difference )/UINT8_MAX))/ampFact; piruett = trans s~
radius ;
53. Any rotation involves one motor turning faster than the other. At some point, faster is not possible and so the leading motor’s thrust is clipped. It seems better to compromise speed rather than turning.
If there is no thrust then it is in piruett mode and spins CW or CCW. While thrust is present, piruett mode is locked out. Piruett mode has a lock function too, to keep it from hopping into directly into thrust mode while it is spinning around. This is partly for noise immunity and partly to help avoid collisions.
if (trans s~
thrust 6= STOPPED ∧ lock ≡ OFF) {
trans s~

larboardOut = int32clamp(speed − rotation, −max , max ); trans s~

starboardOut = int32clamp(speed + rotation, −max , max ); }
else /∗ piruett mode ∗/
{ lock = (abs (piruett) > pirLockLevel) ? ON : OFF;
trans s~

larboardOut = int32clamp(piruett, −max , max );

54. For starboard, piruett is reversed, making it rotate counter to larboard. piruett = −piruett;
trans s~

starboardOut = int32clamp(piruett, −max , max ); } }

22 | RADIUS TRANSLATOR | PIRUETT | §55
55. This procedure sets the signal to the H-Bridge. Forward is positive an negative is reverse. For the PWM we load the value into the unsigned registers. There is no duty-cycle limit here.
void setPwm(int16 t larboardOut, int16 t starboardOut)
{
if (larboardOut ≥ 0) {
larboardDirection(FORWARD);
OCR0A = abs (larboardOut); }
else {
larboardDirection(REVERSE); OCR0A = abs (larboardOut); }
if (starboardOut ≥ 0) {
starboardDirection(FORWARD); OCR0B = abs (starboardOut); }
else {
starboardDirection(REVERSE); OCR0B = abs (starboardOut); }

§56 | PIRUETT | SIMPLE CONTROLS | 23
56. Simple Controls.
57. We must see if the fail-safe relay needs to be closed. if (larboardOut ∨ starboardOut) relayCntl(CLOSED); else relayCntl(OPEN);
}
58. Here is a simple procedure to flip the LED on or off.
void ledCntl(int8 t state )
{
PORTB = state ? PORTB | (1 PORTB5) : PORTB & ∼(1 PORTB5);
}
59. Here is a simple procedure to flip the Relay Closed or Open from pin D8. void relayCntl(int8 t state )
{
PORTB = state ? PORTB | (1 PORTB0) : PORTB & ∼(1 PORTB0);
}
60. Here is a simple procedure to set thrust direction on the larboard motor. void larboardDirection(int8 t state )
{
if (state ) PORTD &= ∼(1 PORTD3);
else PORTD |= (1 PORTD3);
}
61. Here is a simple procedure to set thrust direction on the starboard motor. void starboardDirection(int8 t state )
{
if (state ) PORTD &= ∼(1 PORTD4);
else PORTD |= (1 PORTD4);
}
62. A simple 32 bit clamp function.
int32 t int32clamp(int32 t value , int32 t min, int32 t max )
{
return (value > max ) ? max : (value < min) ? min : value ; }

24 | DIRECT DIGITAL CONTROLLER | PIRUETT | §63
63. | Direct Digital Controller. | This is the DDC or Direct Digital Control algorithm used for the dive
control.
It is largely based on an algorithm from the book Control and Dynamic Systems by Yasundo Takahashi, et al. (1970). This is a nice, easy to compute iterative (velocity) algorithm.

∆mN = Kp(cN−1 − cN ) + Ki(rN − cN ) + Kd(2cN−1 − cN−2 − cN )

where
Ki = T /T1, Kd = Td/T.

Everything is integrated so the proportional starts as a derivative and the derivative starts as a second derivative. It’s a unique form, since error is seen only through the integral.
Takahashi suggested a four point difference for the derivative, if the signal is noisy. Our signal may be very noisy so this feature has been included. Takahashi’s four point difference was a bit involved, so to make this easy, I used numerical differentiation coefficients from the CRC Standard Mathematical Tables, 27th Edition (1985). The four point technique has also been extended to the proportional term. With all that it will have some inherent filtering. The coefficients in the array are arranged in order, to use on the oldest to latest sample.
A final difference from Takahashi’s book form is that the integral is in terms of repeats per unit-time. This function takes a structure pointer. That structure holds everything unique to the channel of control, including the process and output history.
The variable offset is computed from the distance between pointers. offset, with some modulus arithmetic, is used to move pPvLast to the destination of the next process sample. This new location is also the present location of the oldest sample—that will be the first sample used for the derivatives. In mode MANUAL it just returns from here, but in AUTOMATIC the output is updated.
The derivatives are then calculated, from the four last samples of the process variable, using the coefficients. This begins at the oldest sample, indicated by offset, and walks to the latest.
Next, the error between process and setpoint is computed.
We then integrate the process variable’s derivative, the error and the process variable’s second derivative. That results in a correction based on the process’s proportional, the error’s integral and process’s derivative. Finally, the running output is clamped to the limits, which could be the limits of the integer’s type, or something smaller.
A safe value should be written to m before starting control. This function should be called after a fresh process variable has been written to pPvLast.
int16 t takDdc(ddcParameters ∗pPar s )
{
| const int8 t derCoef [ ] = {2, −9, 18, −11}; | /∗ these four coefficients are in sixths ∗/
const int8 t secDerCoef [ ] = {2, −5, 4, −1}; | /∗ these four are in units ∗/
Static assert(sizeof (derCoef )/sizeof (derCoef [0]) ≡ PIDSAMPCT, "PID sample mismatch"); Static assert(sizeof (secDerCoef )/sizeof (secDerCoef [0]) ≡ PIDSAMPCT, "PID sample mismatch"); int32 t total ;
int8 t offset = pPar s~

pPvLast − pPar s~
pPvN ;
pPar s~

pPvLast = pPar s~

pPvN + (++offset % PIDSAMPCT); /∗ at this point offset points at the oldest sample ∗/
if (pPar s~mode ≡ AUTOMATIC) { int32 t dDer = 0, dSecDer = 0; for (int8 t coefIdx = 0; coefIdx < PIDSAMPCT; coefIdx ++) { dDer += (int32 t)derCoef [coefIdx ] ∗ pPar s~

pPvN [offset % PIDSAMPCT]; dSecDer += (int32 t)secDerCoef [coefIdx ] ∗ pPar s~

pPvN [offset % PIDSAMPCT]; offset ++;
} /∗ Since the derivative was in sixths we must divide by six ∗/ dDer /= 6L; int32 t error = (int32 t)pPar s~

setpoint −∗pPar s~

pPvLast; total = (int32 t)pPar s~ k p
∗ ( dDer + (int32 t)pPar s~

k i ∗ (int32 t) error −(int32 t) pPar s~

k d ∗ dSecDer ) ;
pPar s~m = int32clamp((pPar s~m + total), pPar s~mMin, pPar s~mMax ); } return pPar s~m; }

§64 | PIRUETT | CONTROL INITIALIZATION | 25
64. | Control Initialization. | Takahashi Direct Digital Control PID and Period initialization. Call this
once to set parameters, or when they are changed.
void takDdcSetPid (ddcParameters ∗pPar s , int16 t p, int16 ti, int16 t d, int16 tt)
{
pPar s~

t = t;
pPar s~

k p = p;
pPar s~

k i = i ∗ pPar s~
t;
pPar s~

k d = d ∗ pPar s~

t; /∗ set the process value pointer to the first position ∗/ pPar s~

pPvLast = pPar s~

pPvN ;
}

26 | PERIPHERAL INITIALIZATION | PIRUETT | §65
65. Peripheral Initialization.
66. | hInitialize pin outputs 66 i ≡ | /∗ set the led port direction; This is pin #17 ∗/
DDRB |= (1 DDB5); | /∗ set the relay port direction; This is pin #8 ∗/
DDRB |= (1 DDB0); | /∗ 14.4.9 DDRD The Port D Data Direction Register ∗/
/∗ larboard and starboard pwm outputs ∗/
DDRD |= ((1 DDD5) | (1 DDD6)); /∗ Data direction to output (sec 14.3.3) ∗/
/∗ larboard and starboard direction outputs ∗/
DDRD |= ((1 DDD3) | (1 DDD4)); /∗ Data direction to output (sec 14.3.3) ∗/
/∗ set the dive input port direction; This is pin #8 ∗/
DDRB |= (1 DDD0);

This code is used in section 18.

67. | hInitialize pin inputs 67 i ≡ | /∗ set the dive input port direction; This is FTDI pin #4 ∗/
DDRB &= ∼(1 DDD0); | /∗ set the dive input pull-up ∗/
PORTD |= (1 PORTD0);

This code is used in section 18.

### 68. h Configure to idle on sleep 68 i ≡

{
SMCR &= ∼((1 SM2) | (1 SM1) | (1 SM0));
}

This code is used in section 21.

§69 | PIRUETT | CONFIGURATION | 27
69. | Configuration. | This section configures the analog section for both analog and input capture through
the MUX. Since the MUX is used, AIN1 and AIN0 may still be used for digital data comming from the receiver. Default is ICR on channel 0 but by setting the MUX to channel ADC2 and clearing ADEN, an ADC conversion will occur on the next idle. Conversion will take about 191 µs and will complete with an interrupt.

### 70. hInitialize capture mode 70 i ≡

{ | /∗ ADCSRA ADC Control and Status Register A ∗/
ADCSRA &= ∼(1 ADEN); | /∗ Conn the MUX to (-) input of comparator (sec 23.2) ∗/
ADCSRA |= ((1 ADPS2) | (1 ADPS1) | (1 ADPS0)); | /∗ prescaler to 128 ∗/
if ANALOG ADCSRA |= (1 ADIE); | /∗ ADC to interrupt on completion ∗/
# endif | /∗ 23.3.1 ADCSRB ADC Control and Status Register B ∗/

ADCSRB |= (1 ACME); | /∗ Conn the MUX to (-) input of comparator (sec 23.2) ∗/
/∗ 24.9.5 DIDR0 Digital Input Disable Register 0 ∗/
DIDR0 |= ((1 ADC2D) | (1 ADC1D) | (1 ADC0D)); /∗ Disable din (sec 24.9.5) ∗/
/∗ 23.3.2 ACSR Analog Comparator Control and Status Register ∗/
ACSR |= (1 ACBG); | /∗ Connect + input to the band-gap ref (sec 23.3.2) ∗/
ACSR |= (1 ACIC); | /∗ Enable input capture mode (sec 23.3.2) ∗/
ACSR |= (1 ACIS1); | /∗ Set for both rising and falling edge (sec 23.3.2) ∗/
/∗ 16.11.8 TIMSK1 Timer/Counter1 Interrupt Mask Register ∗/
if CAPTURE TIMSK1 |= (1 ICIE1); | /∗ Enable input capture interrupt (sec 16.11.8) ∗/
# endif | /∗ 16.11.2 TCCR1B Timer/Counter1 Control Register B ∗/

TCCR1B |= (1 ICNC1); | /∗ Enable input capture noise canceling (sec 16.11.2) ∗/
TCCR1B |= (1 CS10); | /∗ No Prescale. Just count the main clock (sec 16.11.2) ∗/
/∗ 24.9.1 ADMUX ADC Multiplexer Selection Register ∗/
ADMUX = (ADMUX & #f0) | 0U; | /∗ Set to mux channel 0 ∗/
ADMUX |= (1 REFS0) | (1 REFS1); | /∗ Set ADC to use internal 1.1 V reference ∗/
}

This code is used in section 18.

### 71. For a timer tick at each 1

4

second. We will use timer counter 2, our last timer. This 8 bit timer only has a 10 bit prescaler so it will need to be divided a lot. The prescaler is set to it’s maximum of 1024 for 15625 Hz from the 16 Mhz clock. The timer is set to CTC mode so that the time loop is trimmable. In software, we want to divide by a power of two so we can use a simple compare and, here in this timer, no counter resets.
We ultimately need a divisor of 15625
4

or 3906. A divisor of 256 is possible in the counter. 3906.2/256 is very near a power of 2, specifically 16. 3906.2 is 244.14, and, according to the datasheet, it interrupts one count past that. The time is trimmed to make 16 passes close to 0.25 seconds by loading compare register, OCR2A, with 243. The interval, with the software divisor, is f =

| | fCP U
divisor×prescale×(1+registercompare)
or | 16×16⁶
256×1024×(1+243) ≈ 0.25seconds. The interrupt is enabled TIMSK2 for output compare register A. With all that we will have interrupt TIMER2 COMPA fire every 15.616 ms.

28 | CONFIGURATION | PIRUETT | §72

### 72. hInitialize tick timer 72 i ≡

{
| TCCR2B |= (1 CS22) | (1 CS21) | (1 CS20); | /∗ maximum prescale (see 18.11.2) ∗/
TCCR2A |= (1 WGM21); | /∗ CTC mode (see 18.11.1) ∗/
OCR2A = 243U;
#if TICK

TIMSK2 |= (1 OCIE2A); /∗ Interrupt on a compare match ∗/ #endif
}

This code is used in section 18.

73. See section 11.8 in the datasheet for details on the Watchdog Timer. This is in the “Interrupt Mode” through WDIE. When controlled remotely or in an autonomous dive this should not time-out.

### 74. hInitialize watchdog timer 74 i ≡

{
wdt reset( );
MCUSR &= ∼(1 WDRF);
WDTCSR |= (1 WDCE) | (1 WDE); /∗ This combo unlocks it ∗/
WDTCSR = (1 WDE) | (1 WDP2) | (1 WDP0);
WDTCSR |= (1 WDIE); /∗ Set the interrupt on ∗/
/∗ Reset is after about 0.5 seconds (see 11.9.2) ∗/
}

This code is used in section 18.

75. PWM setup isn’t too scary. Timer Counter 0 is configured for “Phase Correct” PWM which, according to the datasheet, is preferred for motor control. OC0A (port) and OC0B (starboard) are used for PWM. The prescaler is set to clk/8 and with a 16 MHz clock the f is about 3922 Hz. We are using Set on comparator match to invert the PWM, suiting the glue-logic which drives the H-Bridge.

### 76. hInitialize the Timer Counter 0 for PWM 76 i ≡

{ | /∗ 15.9.1 TCCR0A Timer/Counter Control Register A ∗/
TCCR0A |= (1 WGM00); | /∗ Phase correct, mode 1 of PWM (table 15-9) ∗/
TCCR0A |= (1 COM0A1); | /∗ Set/Clear on Comparator A match (table 15-4) ∗/
TCCR0A |= (1 COM0B1); | /∗ Set/Clear on Comparator B match (table 15-7) ∗/
TCCR0A |= (1 COM0A0); | /∗ Set on Comparator A match (table 15-4) ∗/
TCCR0A |= (1 COM0B0); | /∗ Set on Comparator B match (table 15-7) ∗/
/∗ 15.9.2 TCCR0B Timer/Counter Control Register B ∗/
TCCR0B |= (1 CS01); /∗ Prescaler set to clk/8 (table 15-9) ∗/
}

This code is used in section 20.

§77 | PIRUETT | THE END | 29
77. The End.

Static assert: 63.
abs : 36, 53, 55.
ACBG: 70.
ACIC: 70.
ACIS1: 70.
ACME: 70.
ACSR: 70.
ADC vect: 29.
ADCSRA: 45, 46, 70.
ADCSRB: 70.
ADCW: 45.
ADC0D: 70.
ADC1D: 70.
ADC2D: 70.
ADEN: 45, 46, 70.
ADIE: 70.
ADMUX: 45, 46, 70.
ADPS0: 70.
ADPS1: 70.
ADPS2: 70.
ALLOWPRESSURE: 9, 32, 38, 40, 41, 46. ampFact: 50, 51, 52.
ANALOG: 6, 70.
AUTOMATIC: 4, 17, 63.
buffEnd : 44, 45.
buffIndex : 44, 45.
buffStart: 44, 45.
CAPTURE: 6, 70.
ch1duration: 11, 32, 36.
ch1fall : 11, 32.
CH1FALL: 9, 32, 46.
CH1RISE: 9, 17, 32, 46.
ch1rise : 11, 32.
ch2duration: 11, 32, 36.
ch2fall : 11, 32.
CH2FALL: 9, 32, 46.
CH2RISE: 9, 32, 46.
ch2rise : 11, 32.
CLEAR: 4.
cli : 18.
CLOSED: 4, 57.
coefIdx : 63.
COM0A0: 76.
COM0A1: 76.
COM0B0: 76.
COM0B1: 76.
controlMode : 11, 17, 32, 36, 38, 41, 42, 43. controlModes t: 10, 11.
CS01: 76.
CS10: 70.
CS20: 72.

CS21: 72.
CS22: 72.
DDB0: 66.
DDB5: 66.
ddcParameters: 8, 11, 14, 17, 63, 64. DDD0: 66, 67.
DDD3: 66.
DDD4: 66.
DDD5: 66.
DDD6: 66.
dDer : 63.
DDRB: 66, 67.
DDRD: 66.
deadBand : 12, 35, 36.
debcount: 42.
debounceSet: 42.
debounceTime : 39, 42.
depthCalc: 14, 29, 44.
derCoef : 63.
DIDR0: 70.
difference : 51, 52.
diveTick : 14, 28, 39.
DIVING: 10, 32, 41, 42, 43. divingCount: 39, 43.
divingSeconds : 39, 43.
dSecDer : 63.
edge : 11, 17, 22, 32, 34, 38, 40, 41, 46. edges t: 9, 11.
edgeSelect: 14, 22, 32, 40, 46.
F_CPU: 3.
FALSE: 4, 37, 42.
FORWARD: 4, 55.
gain: 44, 45, 50.
handleIrq : 15, 25, 27, 28, 29, 30. ICES1: 46.
ICF1: 47.
ICIE1: 70.
ICNC1: 70.
ICR1: 32.
idle : 21, 24.
IDLE: 10, 17, 32, 36, 38, 42, 43.
input: 14, 48, 49, 50.
inputScale s : 48.
inputStruct: 11, 14, 15, 17, 31, 33, 38, 39, 44, 46. INT16_MAX: 51.
INT16_MIN: 51.
int16 t: 8, 11, 12, 14, 34, 36, 41, 44, 51, 55, 63, 64. int32 t: 14, 48, 50, 62, 63.
int32clamp: 14, 53, 54, 62, 63.
int8 t: 8, 11, 12, 14, 42, 51, 58, 59, 60, 61, 63. ISR: 15, 27, 28, 29, 30.

30 | THE END | PIRUETT | §77

k d : 8, 63, 64.
k i : 8, 63, 64.
k p: 8, 63, 64.
larboardDirection: 14, 55, 60. larboardOut: 12, 36, 37, 51, 53, 55, 57. ledCntl : 14, 37, 58.
lock : 51, 53.
lostSignal : 14, 30, 38.
main: 16.
MANUAL: 4, 63.
max : 8, 14, 51, 53, 54, 62. MAX_DUTYCYCLE: 5, 41, 51.
maxOut: 14, 34, 36, 48, 49, 50. MCUSR: 74.
min: 8, 14, 62.
minOut: 14, 34, 36, 48, 49, 50. mMax : 8, 17, 41, 63.
mMin: 8, 17, 41, 63.
mode : 8, 17, 63.
OCIE2A: 72.
OCR0A: 55.
OCR0B: 55.
OCR2A: 72.
OFF: 4, 37, 51, 53.
offset: 44, 45, 50, 63.
ON: 4, 6, 37, 53.
oneSecond : 39, 41.
OPEN: 4, 57.
output: 41.
outputCh1 : 36.
outputCh2 : 36.
PD0: 42.
PIDSAMPCT: 8, 63.
PIND: 42.
pInput s : 17, 22, 25, 31, 32, 33, 36, 37, 38, 39, 40, 41, 42, 43, 44, 45, 46.
pirLockLevel : 51, 53.
piruett: 51, 52, 53, 54.
PORTB: 58, 59.
PORTB0: 59.
PORTB5: 58.
PORTD: 60, 61, 67.
PORTD0: 67.
PORTD3: 60.
PORTD4: 61.
pPar s : 63, 64.
pPid s : 11, 17, 41.
pPvLast: 8, 41, 63, 64.
pPvN : 8, 63, 64.
processDepth : 11, 41, 45. pTranslation s : 35, 36, 37. pwcCalc: 14, 27, 30, 31.

pwcMaxIn: 11, 14, 34, 36, 48, 49, 50. pwcMinIn: 11, 14, 34, 36, 48, 49, 50. radius : 12, 36, 51, 52.
REFS0: 70.
REFS1: 70.
relayCntl : 14, 57, 59.
REMOTE: 10, 32, 36, 38.
REVERSE: 4, 55.
rotation: 51, 52, 53.
scaler : 14, 36, 41, 48.
secDerCoef : 63.
sei : 19.
SET: 4.
Set: 75.
setDepth : 11, 17, 41.
setpoint: 8, 17, 63.
setPwm: 14, 36, 38, 41, 55. sleep: 21.
sleep mode : 24.
SMCR: 68.
SM0: 68.
SM1: 68.
SM2: 68.
speed : 51, 52, 53.
starboardDirection: 14, 55, 61. starboardOut: 12, 36, 37, 51, 53, 54, 55, 57. state : 14, 58, 59, 60, 61.
STOPPED: 4, 53.
stopped : 11, 37, 42.
SUBMERGED: 10, 41, 43.
submersedCount: 39, 43.
submersedSeconds : 39, 43. sum: 44, 45.
takDdc: 14, 41, 63.
takDdcSetPid : 14, 17, 64. TCCR0A: 76.
TCCR0B: 76.
TCCR1B: 46, 70.
TCCR2A: 72.
TCCR2B: 72.
thrust: 12, 36, 51, 53.
thrustCalc: 14, 32, 33.
TICK: 6, 72.
tickCount: 39, 41.
TIFR1: 47.
TIMER1 CAPT vect: 27.
TIMER2 COMPA vect: 28.
TIMSK1: 70.
TIMSK2: 72.
tolDepth : 11, 41.
total : 63.
track : 12, 35, 52.

§77 | PIRUETT | THE END | 31

trans

s

: 51

, 52

, 53

, 54

translate

: 14

, 36

, 51

translation

s

: 24

transStruct
: 12

, 14

, 35

, 51

TRUE

:

4

, 37

, 42

uint16

t

: 11

, 34

, 39

, 44

, 45

UINT8_MAX

: 41

, 51

, 52

uint8

t

: 39

, 42

value

: 14

, 62

WATCHDOG

:

6

, 24

WDCE

: 74

WDE

: 74

WDIE

: 24

, 74

WDP0

: 74

WDP2

: 74

WDRF

: 74

wdt reset

: 32

, 38

, 41

, 74

WDT vect

: 30

WDTCSR

: 24
, 74
WGM00

: 76

WGM21

: 72

32 | NAMES OF THE SECTIONS | PIRUETT h Configure to idle on sleep 68 i Used in section 21. h Global variables 15 i Used in section 2. hInclude 7 i Used in section 2. hInitialize capture mode 70 i Used in section 18. hInitialize pin inputs 67 i Used in section 18. hInitialize pin outputs 66 i Used in section 18. hInitialize the Timer Counter 0 for PWM 76 i Used in section 20. hInitialize tick timer 72 i Used in section 18. hInitialize watchdog timer 74 i Used in section 18. hPrototypes 14 i Used in section 2. h Types 8, 9, 10, 11, 12 i Used in section 2.
