bjornburton/ChampBot2016/Firmware/jawAndFireControl/jafco.pdf

§1 | JAFCO | INTRODUCTION | 1

September 22, 2016 at 15:32

1. | Introduction. | This is the firmware portion of Jaw and Fire control.
This will facilitate two actions: opening the jaw to release the floating object and light the target on fire. The jaw will close by return-spring so the action will to open it.
Fire is a sequence of opening the jaw, releasing the butane and firing the ignitor.

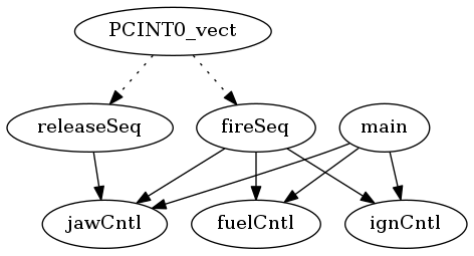
[picture p4: figure]

Extensive use was made of the datasheet, Atmel “Atmel ATtiny25, ATtiny45, ATtiny85 Datasheet” Rev. 2586QAVR08/2013 (Tue 06 Aug 2013 03:19:12 PM EDT) and “AVR130: Setup and Use the AVR Timers” Rev. 2505AAVR02/02.
hInclude 4 i
hPrototypes 5 i
h Global variables 6 i
2. "F_CPU" is used to convey the Trinket clock rate. #define F_CPU 8000000UL
3. Here are some Boolean definitions that are used. #define ON 1
#define OFF 0

#define OPEN 1

#define CLOSE 0

#define SET 1

#define CLEAR 0

2 | INTRODUCTION | JAFCO | §4

### 4. hInclude 4 i ≡

#include <avr/io.h> | /∗ need some port access ∗/

#include <util/delay.h> | /∗ need to delay ∗/

#include <avr/interrupt.h> | /∗ have need of an interrupt ∗/

#include <avr/sleep.h> | /∗ have need of sleep ∗/

#include <avr/wdt.h> | /∗ have need of watchdog ∗/

#include <stdlib.h>

#include <stdint.h>

This code is used in section 1.

### 5. hPrototypes 5 i ≡

void jawCntl(uint8 t state ); | /∗ Jaw open and close ∗/
void fuelCntl(uint8 t state ); | /∗ Fuel on and off ∗/
void ignCntl(uint8 t state ); | /∗ on and off ∗/
void releaseSeq (void);
void fireSeq (void);

This code is used in section 1.

6. My lone global variable is a function pointer. This lets me pass arguments to the actual interrupt handlers, should I need to. This pointer gets the appropriate function attached by one of the "ISR()" functions.
h Global variables 6 i ≡
void (∗handleIrq )( ) = Λ;
int main(void)
{
hInitialize interrupts 28 i hInitialize pin inputs 27 i hInitialize pin outputs 24 i hInitialize Timer 26 i

This code is used in section 1.

7. Of course, any interrupt function requires that bit “Global Interrupt Enable” is set; usually done through calling sei(). Doing this after the pin setup is the best time.
sei( );
8. Rather than burning loops, waiting for something to happen, the “sleep” mode is used. The specific type of sleep is ‘idle’. In idle, execution stops but timers continue. Interrupts are used to wake it.
h Configure to wake upon interrupt 34 i
9. This is the loop that does the work. It should spend most of its time in sleep mode , comming out at each interrupt event.
for ( ; ; )
{
10. We don’t want anything cooking while we are asleap. ignCntl(OFF);
fuelCntl(OFF);
jawCntl(CLOSE);
11. Now we wait in “idle” for any interrupt event. sleep mode ( );

§12 | JAFCO | INTRODUCTION | 3
12. If execution arrives here, some interrupt has been detected.
if (handleIrq 6= Λ) /∗ not sure why it would be, but to be safe ∗/
{
handleIrq ( );
handleIrq = Λ; | /∗ reset so that the action cannot be repeated ∗/
} | /∗ end if handleIrq ∗/
} | /∗ end for ∗/
return 0; | /∗ it’s the right thing to do! ∗/
} | /∗ end main() ∗/

4 | INTERRUPT HANDLING | JAFCO | §13
13. Interrupt Handling.
void releaseSeq ( )
{
14. This sequence will proceed only while the button is held. jawCntl(OPEN);
while (¬(PINB & (1 PB3))) delay ms (10); jawCntl(CLOSE); }

15.
void fireSeq ( )
{
uint8 t firingState ;
enum firingStates {
ready , opened , igniting , burning , cooling };
firingState = ready ;
16. This sequence will proceed only while the button is held. It can terminate after any state. "_delay_ms()" is a handy macro good for 2¹⁶ milliseconds of delay.

while (¬(PINB & (1 PB4))) {

17. The jaw opens here for fire.
if (firingState ≡ ready ) { jawCntl(OPEN);
firingState = opened ;
continue;
}
18. CDI is switched on.
if (firingState ≡ opened ) { ignCntl(ON);
firingState = igniting ;
continue;
}
19. Fuel opens.
if (firingState ≡ igniting ) { fuelCntl(ON);
firingState = burning ;
continue;
}
delay ms (10); }
20. Once the loop fails we set fuel and ignitor off and close the jaw. ignCntl(OFF);
fuelCntl(OFF);
jawCntl(CLOSE); }

§21 | JAFCO | THE ISRS | 5
21. The ISRs.
The ISRs are pretty skimpy as they mostly used to point handleIrq ( ) to the correct function. The need for global variables is minimized.
22. This vector responds to the jaw input at pin PB3 or fire input at PB4. A simple debounce is included. ISR(PCINT0 vect)
{
const int8 t high = 32;
const int8 t low = −high ; int8 t dbp3 = 0;
int8 t dbp4 = 0;
while (abs (dbp3 ) < high ) {
if (¬(PINB & (1 PB3)) ∧ dbp3 > low) dbp3 −−; else if ((PINB & (1 PB3)) ∧ dbp3 < high ) dbp3 ++; delay ms (1);
}
while (abs (dbp4 ) < high ) {
if (¬(PINB & (1 PB4)) ∧ dbp4 > low) dbp4 −−; else if ((PINB & (1 PB4)) ∧ dbp4 < high ) dbp4 ++; delay ms (1);
}
if (dbp3 ≡ low) handleIrq = &releaseSeq ;
else if (dbp4 ≡ low) handleIrq = &fireSeq ; }

6 | THESE ARE THE SUPPORTING ROUTINES, PROCEDURES AND CONFIGURATION BLOCKS JAFCO | §23
23. These are the supporting routines, procedures and configuration blocks.
Here is the block that sets-up the digital I/O pins.

### 24. hInitialize pin outputs 24 i ≡

{ | /∗ 14.4.9 DDRD The Port D Data Direction Register ∗/ | /∗ set the jaw port direction ∗/
DDRB |= (1 DDB0); | /∗ set the fuel port direction ∗/
DDRB |= (1 DDB1); | /∗ set the ignition port direction ∗/
DDRB |= (1 DDB2);
}

This code is used in section 6.

25. Timer Counter 0 is configured for “Phase Correct” PWM which, according to the datasheet, is preferred for motor control. OC0A and OC0B are set to clear on a match which creates a non-inverting PWM.

### 26. hInitialize Timer 26 i ≡

{ | /∗ 15.9.1 TCCR0A Timer/Counter Control Register A ∗/
TCCR0A |= (1 WGM00); | /∗ Phase correct, mode 1 of PWM (table 15-9) ∗/
TCCR0A |= (1 COM0A1); | /∗ Set/Clear on Comparator A match (table 15-4) ∗/
TCCR0A &= ∼(1 COM0A0); | /∗ Set on Comparator A match (table 15-4) ∗/
TCCR0A |= (1 COM0B1); | /∗ Set/Clear on Comparator B match (table 15-7) ∗/
TCCR0A &= ∼(1 COM0B0); | /∗ Set on Comparator B match (table 15-7) ∗/
/∗ 15.9.2 TCCR0B Timer/Counter Control Register B ∗/
TCCR0B |= (1 CS01); /∗ Prescaler set to clk/8 (table 15-9) ∗/
}

This code is used in section 6.

### 27. hInitialize pin inputs 27 i ≡

{ | /∗ set the jaw input pull-up ∗/
PORTB |= (1 PORTB3); | /∗ set the fire input pull-up ∗/
PORTB |= (1 PORTB4);
}

This code is used in section 6.

### 28. hInitialize interrupts 28 i ≡

{ | /∗ enable change interrupt for jaw input ∗/
PCMSK |= (1 PCINT3); | /∗ enable change interrupt for fire input ∗/
PCMSK |= (1 PCINT4); | /∗ General interrupt Mask register ∗/
GIMSK |= (1 PCIE);
}

This code is used in section 6.

§34 | JAFCO THESE ARE THE SUPPORTING ROUTINES, PROCEDURES AND CONFIGURATION BLOCKS | 7
29. Here is a simple procedure to operate the jaw.
void jawCntl(uint8 t state )
{
if (state ) {
OCR0A = #ffU;
delay ms (250);
OCR0A = #ccU;
}
else {
OCR0A = #00U;
}
}
30. Here is a simple procedure to operate the fuel. void fuelCntl(uint8 t state )
{
if (state ) {
OCR0B = #ffU;
delay ms (250);
OCR0B = #ffU;
}
else {
OCR0B = #00U;
}
}
31. Here is a simple procedure to operate the ignition.
void ignCntl(uint8 t state )
{
PORTB = state ? PORTB | (1 PORTB2) : PORTB & ∼(1 PORTB2);
}
32. See section the datasheet for details on the Watchdog Timer. We are not using it right now.

### 33. hInitialize watchdog timer 33 i ≡

{
WDTCR |= (1 WDCE) | (1 WDE);
WDTCR = (1 WDIE) | (1 WDP2); /∗ reset after about 0.25 seconds ∗/
}
34. Setting these bits configure sleep mode() to go to “idle”. Idle allows the counters and comparator to continue during sleep.
h Configure to wake upon interrupt 34 i ≡
{
MCUCR &= ∼(1 SM1);
MCUCR &= ∼(1 SM0);
}

This code is used in section 8.
delay ms : 14, 19, 22, 29, 30. abs : 22.
burning : 15, 19.

CLEAR: 3.
CLOSE: 3, 10, 14, 20.
COM0A0: 26.

8 | THESE ARE THE SUPPORTING ROUTINES, PROCEDURES AND CONFIGURATION BLOCKS JAFCO | §34

COM0A1: 26.
COM0B0: 26.
COM0B1: 26.
cooling : 15.
CS01: 26.
dbp3 : 22.
dbp4 : 22.
DDB0: 24.
DDB1: 24.
DDB2: 24.
DDRB: 24.
F_CPU: 2.
fireSeq : 5, 15, 22.
firingState : 15, 17, 18, 19. firingStates: 15.
fuelCntl : 5, 10, 19, 20, 30. GIMSK: 28.
handleIrq : 6, 12, 21, 22. high : 22.
ignCntl : 5, 10, 18, 20, 31. igniting : 15, 18, 19.
int8 t: 22.
ISR: 22.
jawCntl : 5, 10, 14, 17, 20, 29. low: 22.
main: 6.
MCUCR: 34.
OCR0A: 29.
OCR0B: 30.
OFF: 3, 10, 20.
ON: 3, 18, 19.
OPEN: 3, 14, 17.
opened : 15, 17, 18.
PB3: 14, 22.
PB4: 16, 22.
PCIE: 28.
PCINT0 vect: 22.
PCINT3: 28.
PCINT4: 28.
PCMSK: 28.
PINB: 14, 16, 22.
PORTB: 27, 31.
PORTB2: 31.
PORTB3: 27.
PORTB4: 27.
ready : 15, 17.
releaseSeq : 5, 13, 22.
sei : 7.
SET: 3.
sleep mode : 9, 11.
SM0: 34.
SM1: 34.

state : 5, 29, 30, 31.
TCCR0A: 26.
TCCR0B: 26.
uint8 t: 5, 15, 29, 30, 31. WDCE: 33.
WDE: 33.
WDIE: 33.
WDP2: 33.
WDTCR: 33.
WGM00: 26.

JAFCO | NAMES OF THE SECTIONS | 9

h Configure to wake upon interrupt 34 i Used in section 8.
h Global variables 6 i Used in section 1.
hInclude 4 i Used in section 1.
hInitialize Timer 26 i Used in section 6.
hInitialize interrupts 28 i Used in section 6. hInitialize pin inputs 27 i Used in section 6. hInitialize pin outputs 24 i Used in section 6. hInitialize watchdog timer 33 i
hPrototypes 5 i Used in section 1.
