bjornburton/ChampBot2016/diagrammaticModels/Activities/igniteActivity.png

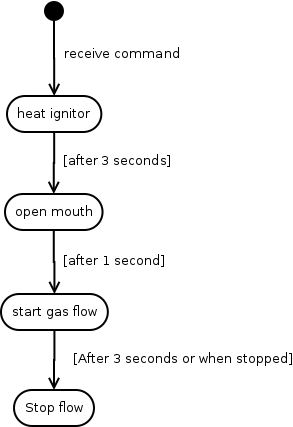
diagrammaticModels/Activities/igniteActivity.png
