bjornburton/ChampBot2016/diagrammaticModels/Activities/manageFloatActivity.png

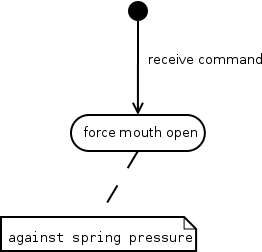
diagrammaticModels/Activities/manageFloatActivity.png
