bjornburton/ChampBot2016/diagrammaticModels/Activities/maneuverActivity.png

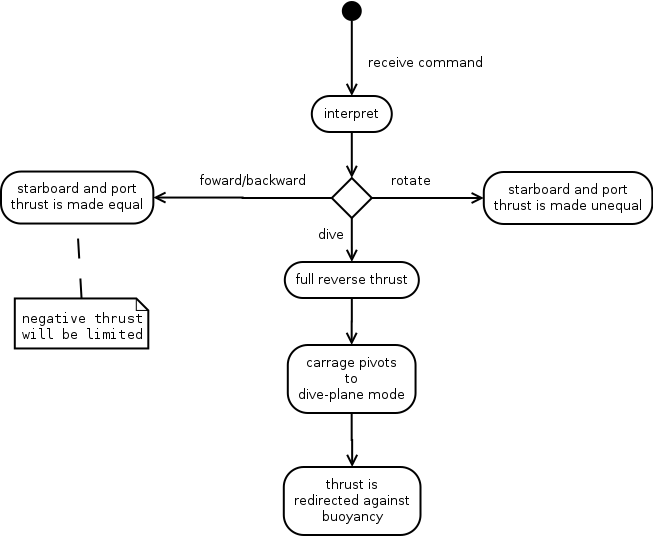
diagrammaticModels/Activities/maneuverActivity.png
