bjornburton/ChampBot2016/diagrammaticModels/useCase/essentialFunctionUseCase.png

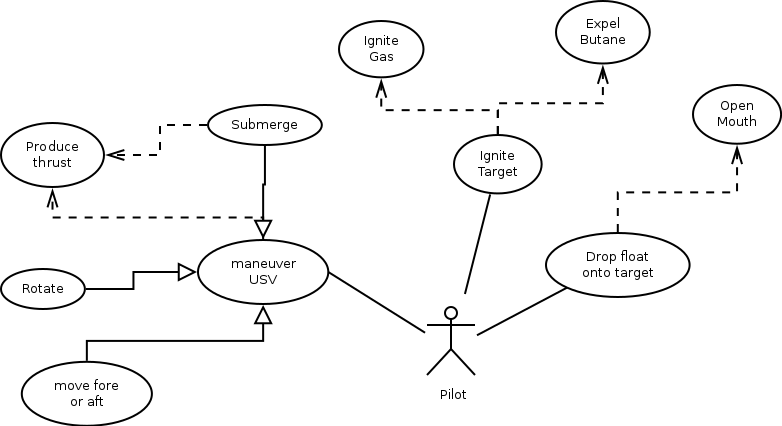
diagrammaticModels/useCase/essentialFunctionUseCase.png
