bjornburton/ChampBot2016/Firmware/propulsion/glue.png

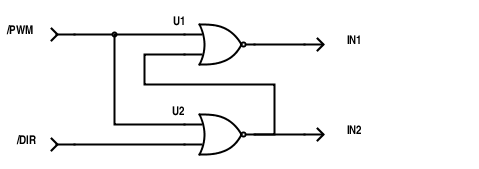
Firmware/propulsion/glue.png
