bjornburton/ChampBot2016/Firmware/propulsion/piruett2.png

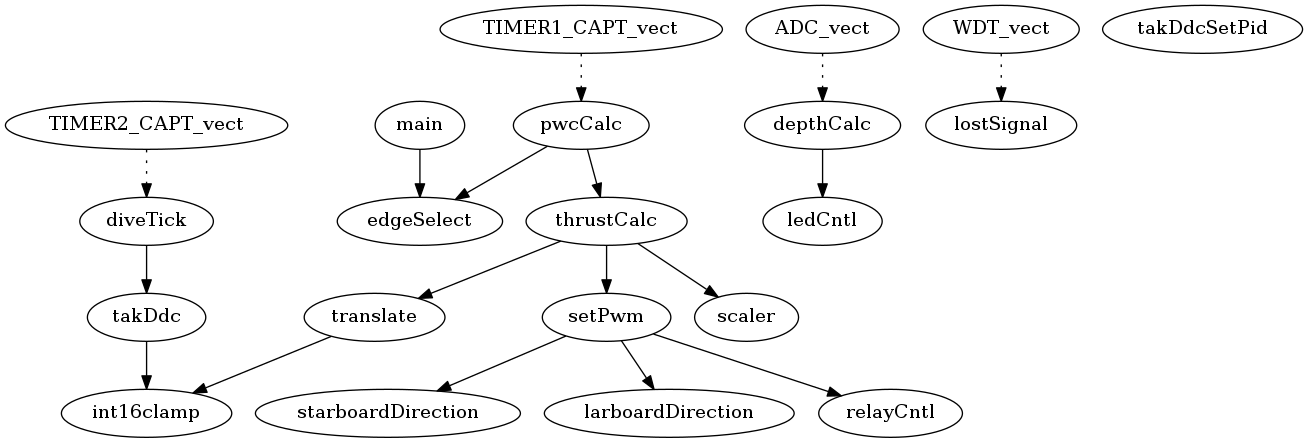
Firmware/propulsion/piruett2.png
