bjornburton/ChampBot2016/Firmware/propulsion/piruett.dot.png

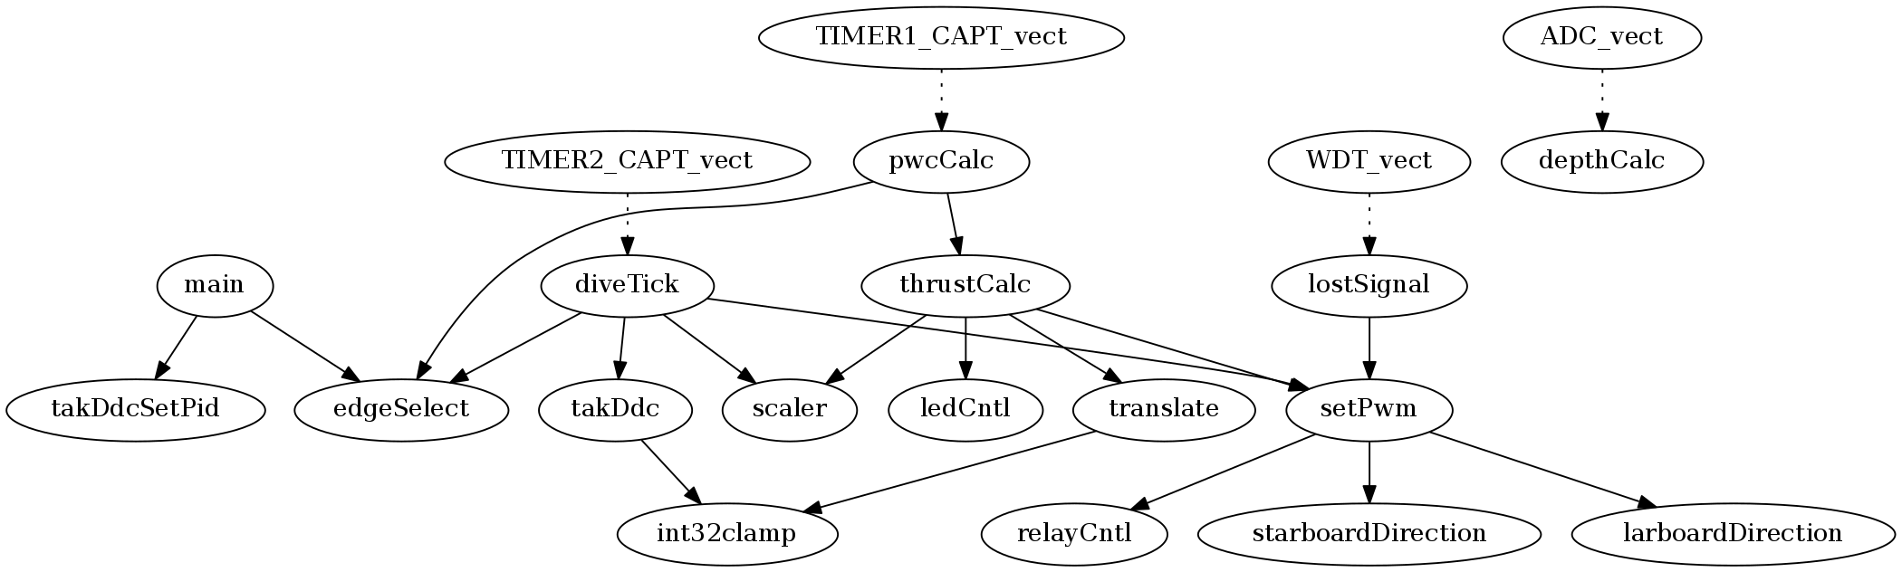
Firmware/propulsion/piruett.dot.png
