bjornburton/ChampBot2016/Definition/champbotFeatureList.ods

Sheet: Features
 |  | Core Feature | Priority | Reason | provided by | Remote | servo | Computer | sub-feature | sub-feature | sub-feature | sub-feature | sub-feature
Done | 20 | Looks like champ | Must Have | rule | upper section | no | no | no | sheds water | metalic green | Light-weight | Fire-resistant head
Done | 20 | moves swiftly | Must Have | race goal | powerful drive units | proportional | Motors(2) |  | Controls as throttle | Large-prop | modest pitch | Gear-reduction | 400 – 500 RPM
Done | 20 | Manovers well | Must Have | race goal | Twin thrustors | proportional | no | yes | Controls as rudder |  | Computer-controlled | wind resistant | stable
Done | 0 | greater that 3 feet | Must Have | rule | design limit | no | no | no
Done | 0 | less than 4 feet | Nice to Have | cost | design limit | no | no | no
Done | 0 | Mouth Height 18” | Nice to Have | Carries float |  | no | no | no
Done | 20 | makes fire | Nice to Have | race goal | burner | digital | Solenoid & relay | yes | managed ignition | Hot-wire ignitor | parent valve | butane | mouth overide
Done | 20 | carries float on rope (size/diameter?) | Nice to Have | race goal | Jaw servo | digital | motor | yes
Done | 20 | Dives | Nice to Have | race goal | Full-reverse thrust | no | no | yes
Done | 20 | Eyes Light up | Don't Need | Warning/Safety | LEDs | no | no | yes
no | 10 | Siren | Don't Need | Warning/Safety | Buzzer | no | no | yes
no | 10 | Spray water | Don't Need | Fun | washer pump | no | no | yes | sprays when diving
Done |  | Low frequency remote for submersion
Done |  | variable motors |  | 2 | thrusters
Done |  | solenoid valve |  | 1 | gas control
Done |  | two position motors with brake |  | 2 | drive pitch & mouth
Done |  | relay |  | 1 | ignitor
 |  | Small canaster with Lindal fitting?

Sheet: Notes
Diameter in cm | Length in cm
9 | 50
 |  |  |  | Metric | US Customary
 |  |  | Area | 63.6172512352 | 9.8606936628
 |  |  | Volume | 3180.8625617597 | 194.1081429693
 |  |  | total Weight | 3.1808625618 | 7.0217716595
 |  |  | Half | 1.5904312809 | 3.5108858298
 |  |  | Force | 15.5968029206 | 3.5108858298
 |  |  | flow | 200 | ml/min |  | Perfect Water Priming Gear DC 3V-12V RS-360SH Pump Micro Spray Motor141015ADBB
 |  |  |  |  |  |  | Minn Kota MKP-2 Power Prop,$12, Wallmart
 |  |  |  |  |  |  | L298N based stepper drive, $3
Course | 30.48
speed desired | 0.5 | m/s |  | Force | 10 | Newtons |  | Fluid Density | 1000 | kg/m 3
rpm | 450 |  |  | Torque | 60 | N*cm
prop |  |  |  | ct | 0.049121896
Diameter in cm | 144
aspect ratio | 0.7
pitch | 100.8
slippage | 30.00%
Pitch speed | 0.756 | m/s
speed | 0.5292 | m/s | 3.0068181818

Sheet: materialSpend
Description | Quantity | Est Cost tot | Act Cost Tot | Combined | In Hand | Usage | Purpose | Displacement in cc | Weight in g | Bouyancy | Displacement Per | Weight per | Weight Wet | rpm | torque Nm | Volt | Notes
Master Gardner WeedEnder 5 Yr. Landscape Fabric | 150 sq ft |  | $4.00 | $4.00 | Yes | 0.1 | skin |  |  | 0 |  | 30g/sq.m | 120g/sq.m
Lifoam Waky Noodle, 13127381, 144.8cm x 6.47 cm, 1.9cm ID | 1 pc |  | $1.00 | $1.00 | Yes | 0.2 | buoyancy | 3003 | 484 | 503.8 | 3003cm3/m | 484g/lin.m |  |  |  |  | B is 2.5 kg/m
Dual H Bridge DC Stepper Motor Drive Controller Board Module Arduino L298N | 3 pc |  | $7.00 | $7.00 | Yes | 0 | drivers |  | 50 | 0
Dual H Bridge, MOSFET, 20A, 30V | 1 pc |  | $30.00 | $25.00 |  | 1 |  |  | 65 | -65
Relay omron G8JN 1C7T DC12, 35A, 12V | 1 pc |  | scrap |  | Yes | 1 | cutoff |  | 35 | -35
New Black & Decker 12 Volt V GC1200 Cordless Compact Cordless Drill | 3 pc |  | $39.00 | $39.00 | Yes | 2 |  | 0 | 437 | -874 |  | <0.9kg each |  | 750 (no load?, figure 400) | 11 (not likely! Figure 5) | 12 | 200 Watts? | 16.6666666667
Nacelle |  |  |  |  |  | 2 |  | 520 | 260 | 520
Proportional remote control, 2ch w receiver, Kyosho Perfex KT-1, 27 MHz | 1 pc |  | $29.00 | $29.00 | Yes | 1 | Thrust & Turn |  |  | 0
4 ch digital remote & spare | 2 pc |  | $16.00 | $16.00 |  | 1 | jaw and fire |  |  | 0
Propellers, MinnKota MKP-2 Replacement Prop, PowerProp | 2 pc |  | $22.00 | $22.00 |  | 2 |  | 75 | 176 | -202
Trinket Attiny | 1 pc |  | $5.00 | $5.00 | Yes | 1 | fire control |  |  | 0
Trinket Pro ATmega328p | 1 pc |  | $10.00 | $10.00 | Yes | 1 | propulsion |  |  | 0
Butane | 2 pc |  | $8.00 | $8.00 |  | 1 | Fuel for target ignition | 180 | 100 | 80
Copper Tube | 1 m |  | scrap |  |  | 0.3 |  |  | 200 | -60
PVC pipe & fittings (Framework) | various |  | $60.00 | $60.00 |  | 0.2 |  | 558.644995705 | 180.0524934383 | 75.7185004533
Enclosure, PVC junction box | 2 pc |  | $20.00 | $20.00 |  | 2 |  | 2360 | 556 | 3608
Seals for motor | 7 pc |  | $5.00 | $5.00 |  | 2 |  |  |  | 0 |  | 556
O rings for Nacelles | 10 pc |  | $5.00 | $5.00 |  | 2 |  |  |  | 0
Epoxy | various |  | $20.00 | $20.00 |  | 3 |  |  |  | 0
Circuit Breaker, 30A | 1 m |  | $5.50 | $5.50 |  | 1 | Power |  |  | 0
Battery, 12V, 5.5 Ah SLA | 1 pc |  | $15.00 | $15.00 |  | 1 | Power | 0 | 1401 | -1401
Nuts & Bolts | various | $50.00 |  | $50.00 |  | 1 |  |  |  | 0
Other (paint, wire) | various | $20.00 |  | $20.00 |  | 1 |  |  |  | 0
Stun Gun | 1 pc |  | $8.00 | $8.00 |  | 1 | Ignitor |  |  | 0
Door-lock servo | 2 ps | $0.00 | $10.00 | $10.00 |  | 2 | Jaw, butane |  |  | 0
Float | 1 pc |  | $5.00 | $5.00 |  | 1 |  |  |  | 500
 |  |  |  | $0.00 |  |  |  |  |  | 0
 |  |  |  | $0.00 |  |  |  |  |  | 0
 |  |  | Planned | $389.50 |  |  |  |  |  | 0
 |  |  | Limit | $500.00
 |  |  | Spent to Date | $324.50 |  |  |  |  |  | 0
 |  |  | Funding: | $129.29 |  |  |  |  |  | 0
 |  |  | Expected Balance: | -$260.21 |  |  |  |  |  | 0
 |  |  |  | $65.00 |  |  |  |  |  | 0
 |  |  |  |  |  |  |  |  |  | 0
 |  |  |  |  |  |  |  | 6696.644995705 | 3944.0524934383 | 2752.5925022667
 |  |  |  |  |  |  |  |  | Full Wt
 |  |  |  |  |  |  |  |  | 8400

Sheet: Funding
Paypal | $129.29
Total | $129.29

Sheet: Sheet5
 |  | r | 1000 |  | 0.995
 |  | t | 10
2.6515151515 |  | 3
 | Track | 2 |  |  |  |  | Track | 2
 |  |  | -255 | gain | 19.6078431373 |  |  |  | -255 | gain | 19.6078431373
 |  |  | 255 | offset | 765 |  |  |  | 255 | offset | 765
 |  |  | 10000 |  |  |  |  |  | 10000
 |  |  | 20000 |  |  |  |  |  | 20000
 | Thrust | input | 20000 | Out: | 255 |  | Thrust | input | 18000 | Out: | 153
 |  |  | -255 | gain | 19.6078431373 |  |  |  | -127 | gain | 39.3700787402
 |  |  | 255 | offset | 765 |  |  |  | 127 | offset | 381
 |  |  | 10000 |  |  |  |  |  | 10000
 |  |  | 20000 |  |  |  |  |  | 20000
 | Radius | input | 15000 | Out: | 0 |  | Radius | input | 16000 | Out: | 25.4
 |  |  |  |  | 0 |  |  |  |  |  | 25.4
 |  | Port |  | Starboard |  |  |  | Port |  | Starboard | speed |  | rotation
 |  | 1 |  | 1 |  | 0 |  | 127.6 |  | 178.4 | 153 | 306 | 50.8
 |  | 255 |  | 255 | 0 | 255
 |  | 10 |  | 10
 |  | 2550 |  | 2550
 |  | 255 |  | 255 |  |  |  | 32512
 |  |  |  |  |  |  |  | 32768
