bjornburton/ChampBot2016/(commit log)

2015-12-27 increased watchdog timer to 0.5 seconds for PI loop
2016-01-01 added diveTick() framework
2016-01-01 placed tick timer initialization
2016-01-01 added TIMER2_COMPA_VECT to Makefile for call-graph
2016-01-03 ADC is set up with prescale, VREF, interrupt and digital disable on the mux pins.
2016-01-04 updated caller graph (egypt/dot) for ADC interupt
    added ADC interrupt handler and pressueCalc procedure to filter pressure for convertion to depth
    added pressureCalc code to reset to comparator and filter pressure readings
    [piruett.c]
2016-01-05 Made the filter sum 16 bit (was 32), improved the text and moved watchdog reset to tick.
    Added assembly command and included .s in clean.
    In main, only call translate when in REMOTE mode.
    Preparing for dive control code.
    [piruett.c]
2016-02-26 bringing in PID code
2016-02-27 most of the PID code is in
2016-02-28 Set up structures for PID.
2016-03-02 corrected derivative calculation. Improved text.
    [piruett.c]
2016-03-03 made the PID code a bit clearer. Imprived the notes.
2016-08-17 perodic update
    [Foil-lift.ods, pressureSensorPlot.ods]
2016-08-25 clarified port and sensor input.
2016-08-28 minor cleanup
    [champbotFeatureList.ods]
2016-09-08 fixed limits and cleaned up.
    [piruett.c]
2016-09-09 fixed ADC.
2016-09-10 Working now. Tested with H-Bridge and relay simulators.
2016-09-11 Moved feeddog() to pwrCalc so that it is only reset with signal, not all interrupts.
    [piruett.c]
2016-09-11 Separated feedDog() into wdt_reset() and keeping WDT in interrupt mode at main for loop. This ensures it does not reset as long as we are looping OK.
    [piruett.c]
2016-09-11 Changed name of pressureCalc to depthCalc() to better convey the use. Added centimeter conversion to depthCalc().
2016-09-12 made pwc, lost-signal and adc work well together.
2016-09-13 beginning cleanup
    [pressureSensorPlot.ods]
2016-09-16 Updated tick so that PID is crunched 0.25 seconds. Improved comments.
2016-09-17 Dive signal input is FTDI RX. Dive and sub timers are in.
2016-09-20 not working out too much
    [piruett.c]
2016-09-20 Dive is no longer kicking out ADC. Toggle (cancel) for dive has been added. Not pretty but maybe later.
    [piruett.c]
2016-09-21 Updated Makefile for installavr. Setup pwm for jaw and fuel.
    Please enter the commit message for your changes. Lines starting
2016-09-22 Corrected spelling and text. Corrected depth calulation. Made submerged time 15 seconds.
    [piruett.c]
2016-09-22 A few corrections. Jaw falls to 80% while fuel stays at 100
    [jafco.c, piruett.c]
2016-09-22 Was not giving 100% when at flank. Had wrong min and max. Hard turns resulted in reversal so track needed to be reduced to 240 units.
    [piruett.c]
